borthalmue/rcm7-surgical-arm/images/card.jpg

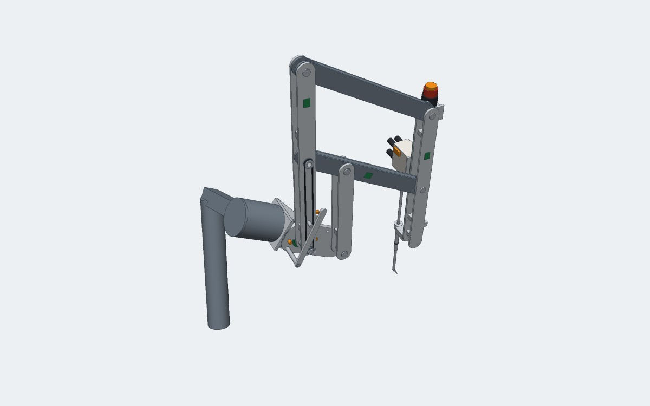
images/card.jpg
