borthalmue/rcm7-surgical-arm/images/insertion-stage.png

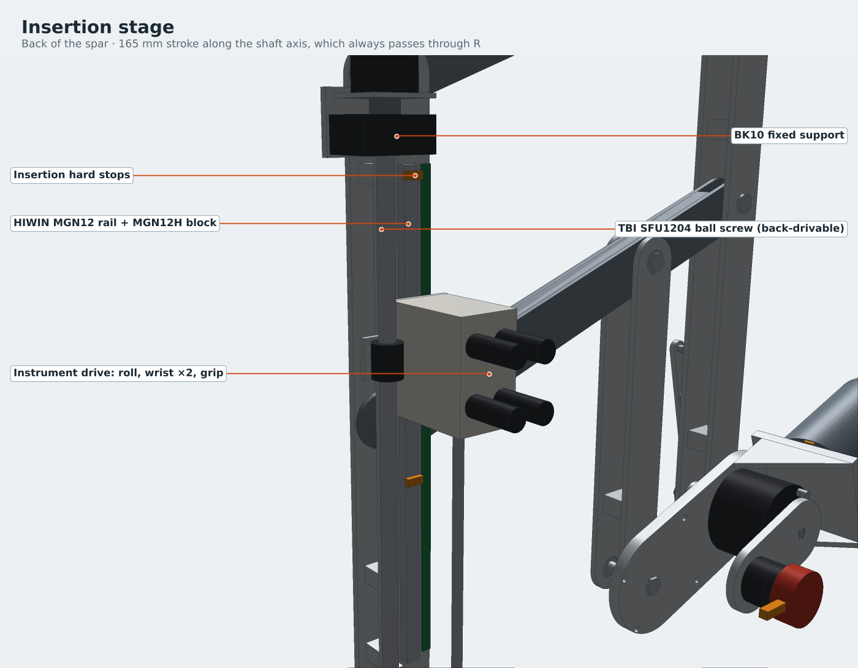
images/insertion-stage.png
