borthalmue/rcm7-surgical-arm/images/pitch-joint.png

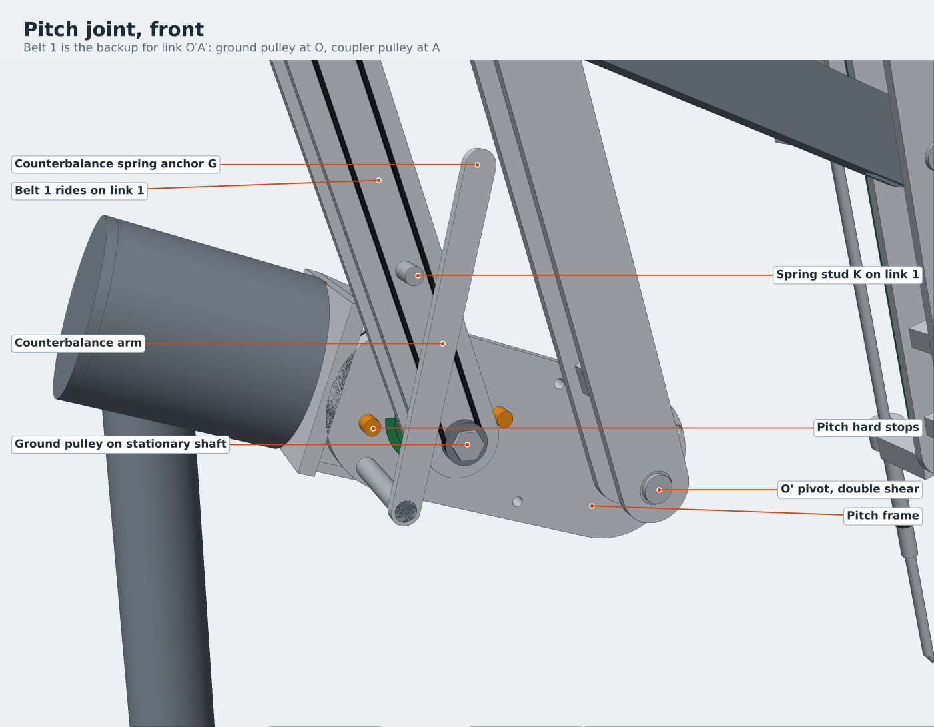
images/pitch-joint.png
