borthalmue/rcm7-surgical-arm/images/rcm-check.png

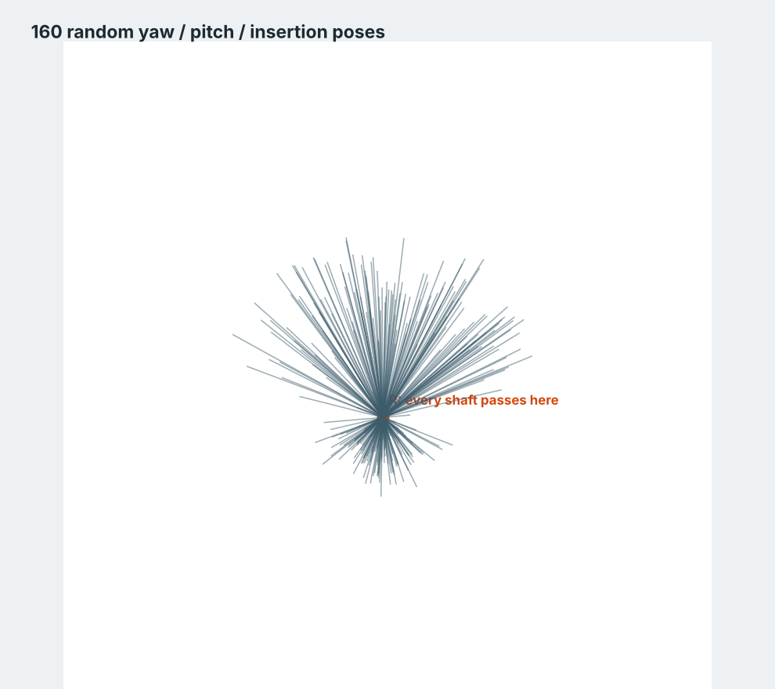
images/rcm-check.png
