borthalmue/rcm7-surgical-arm/cad/RCM7_assembly.stl

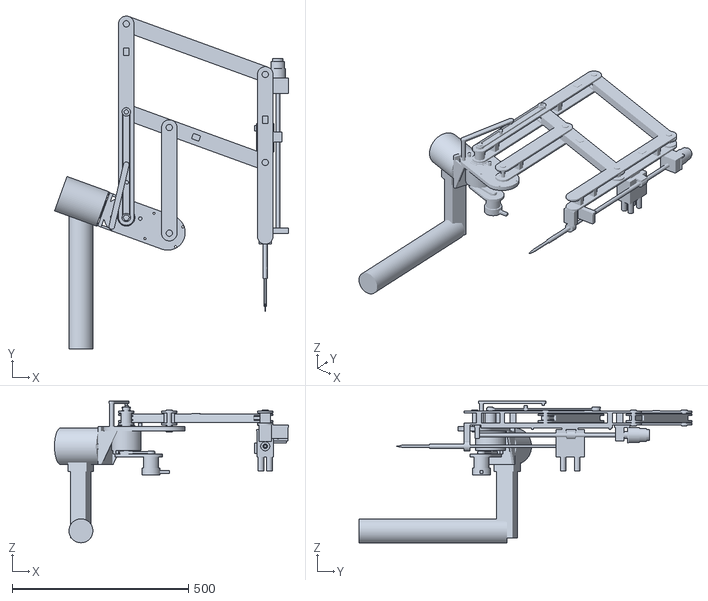
[picture p8: CAD file, 2026-10-20]
cad/RCM7_assembly.stl
664.5 x 945.1 x 402.0
