borthalmue/rcm7-surgical-arm/cad/stl/jaw_1.stl

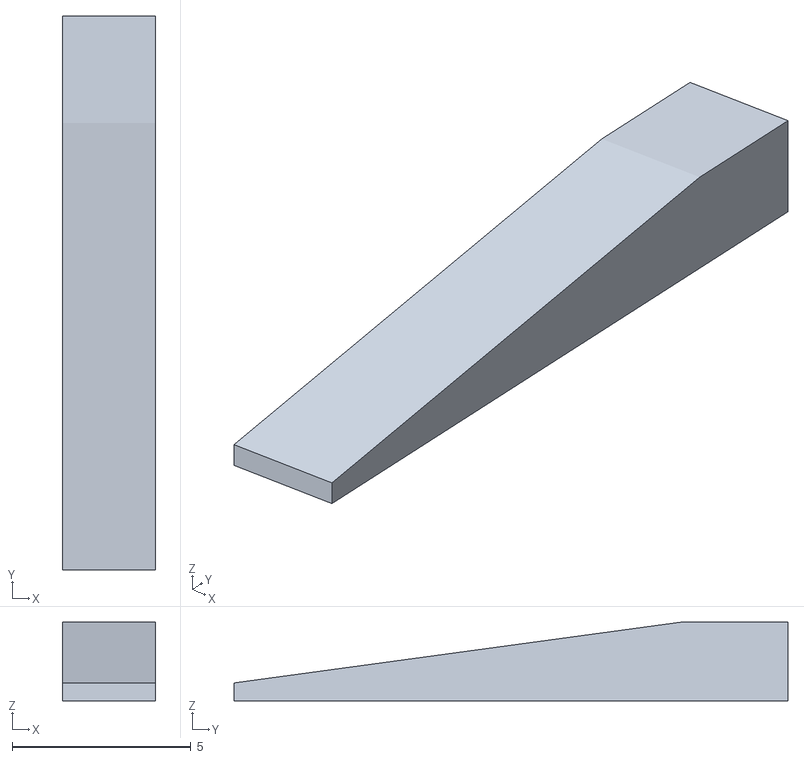
[picture p9: CAD file, 2026-10-20]
cad/stl/jaw_1.stl
2.60 x 15.5 x 2.20
