borthalmue/rcm7-surgical-arm/cad/stl/belt_1.stl

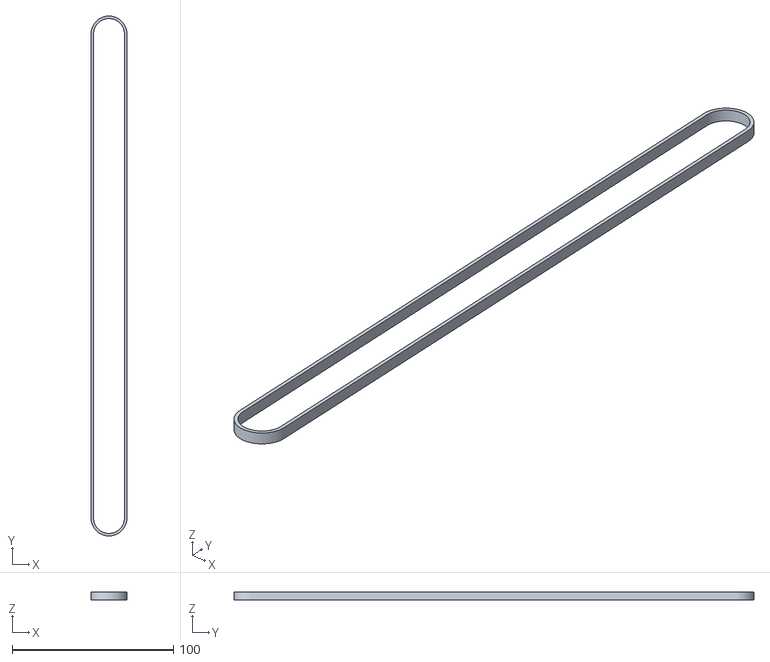
[picture p10: CAD file, 2026-10-20]
cad/stl/belt_1.stl
22.3 x 322.3 x 5.00
