borthalmue/rcm7-surgical-arm/cad/stl/brg_OpAp_front_0.stl

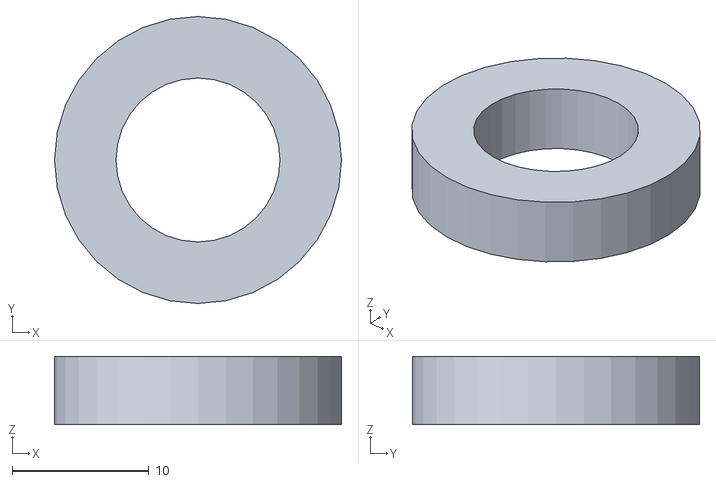
[picture p11: CAD file, 2026-10-20]
cad/stl/brg_OpAp_front_0.stl
21.0 x 21.0 x 5.00
