borthalmue/rcm7-surgical-arm/cad/stl/setup_beam.stl

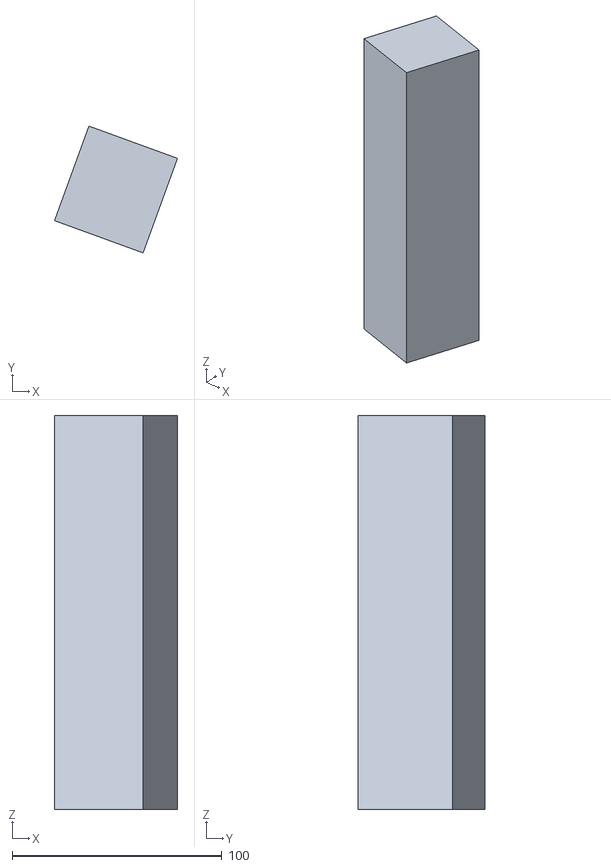
[picture p12: CAD file, 2026-10-20]
cad/stl/setup_beam.stl
58.7 x 60.5 x 188.0
