borthalmue/rcm7-surgical-arm/cad/stl/pitch_ground_shaft.stl

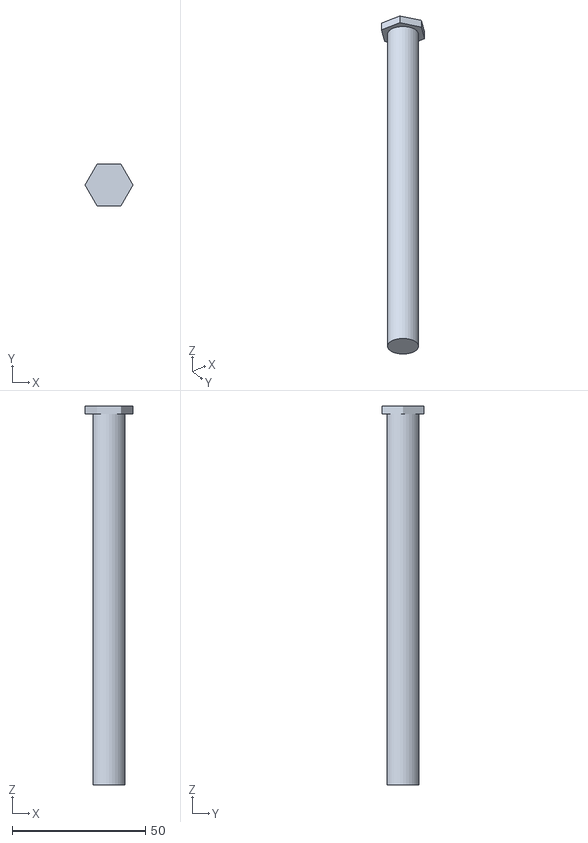
[picture p13: CAD file, 2026-10-20]
cad/stl/pitch_ground_shaft.stl
18.0 x 15.6 x 142.0
