borthalmue/rcm7-surgical-arm/cad/stl/insertion_motor.stl

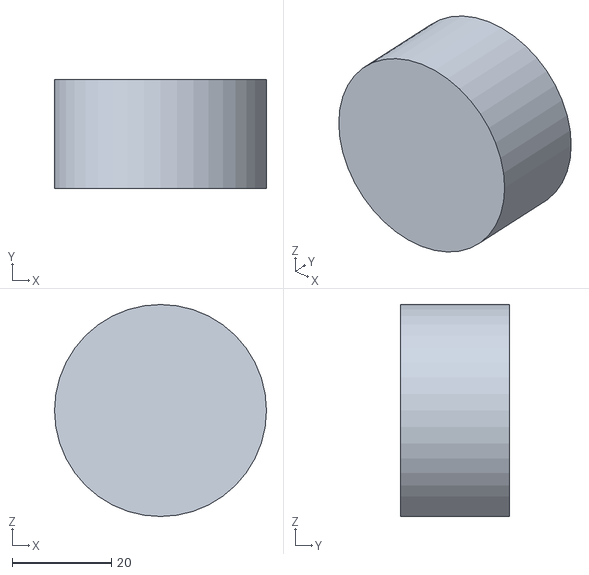
[picture p14: CAD file, 2026-10-20]
cad/stl/insertion_motor.stl
42.8 x 22.0 x 42.8
