borthalmue/rcm7-surgical-arm/cad/stl/coupler2_rail_R.stl

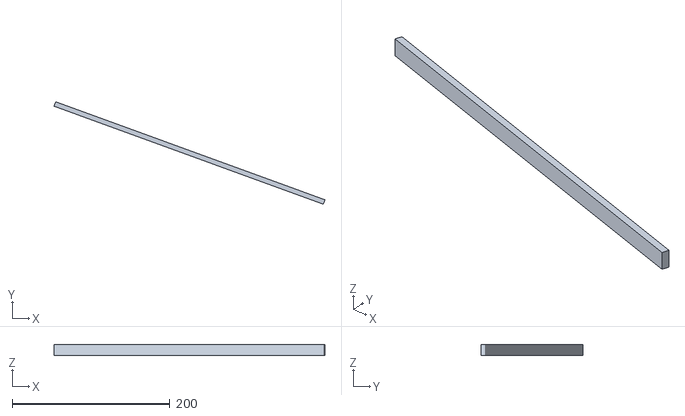
[picture p15: CAD file, 2026-10-20]
cad/stl/coupler2_rail_R.stl
344.1 x 130.1 x 14.0
