borthalmue/rcm7-surgical-arm/cad/stl/spring_post.stl

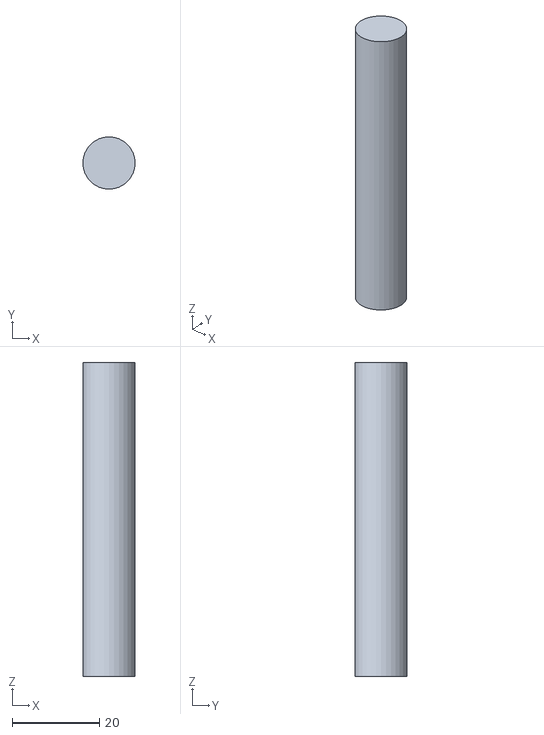
[picture p16: CAD file, 2026-10-20]
cad/stl/spring_post.stl
12.0 x 12.0 x 72.0
