borthalmue/rcm7-surgical-arm/cad/stl/setup_column.stl

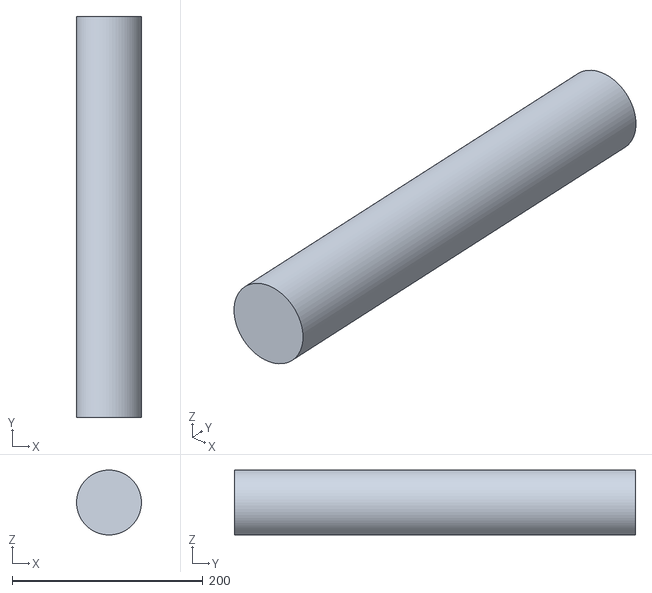
[picture p17: CAD file, 2026-10-20]
cad/stl/setup_column.stl
68.0 x 420.0 x 68.0
