borthalmue/rcm7-surgical-arm/cad/stl/link1_hub.stl

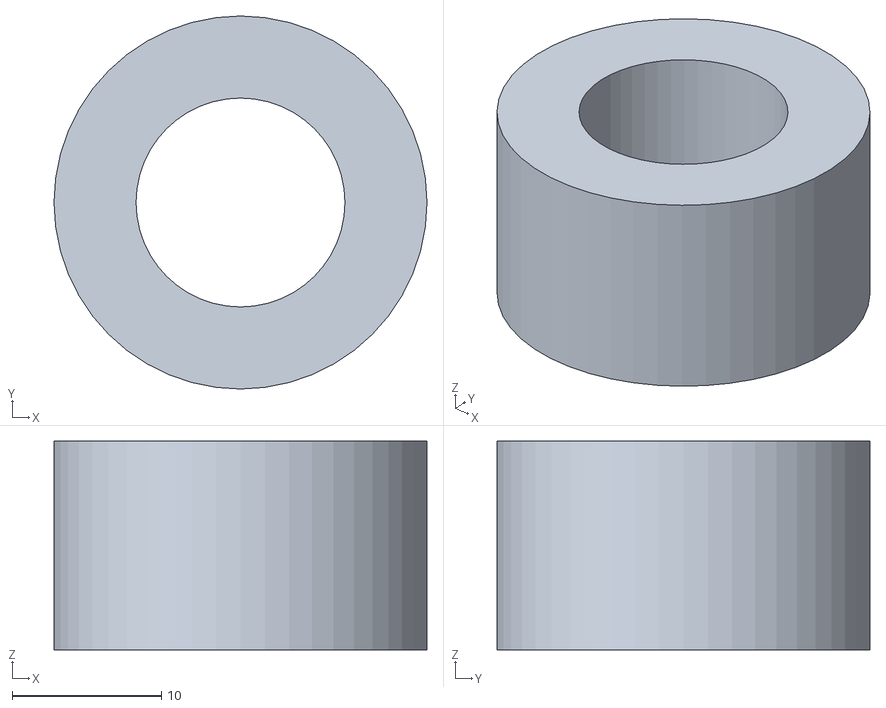
[picture p18: CAD file, 2026-10-20]
cad/stl/link1_hub.stl
25.0 x 25.0 x 14.0
