borthalmue/rcm7-surgical-arm/cad/stl/isa_motor_2.stl

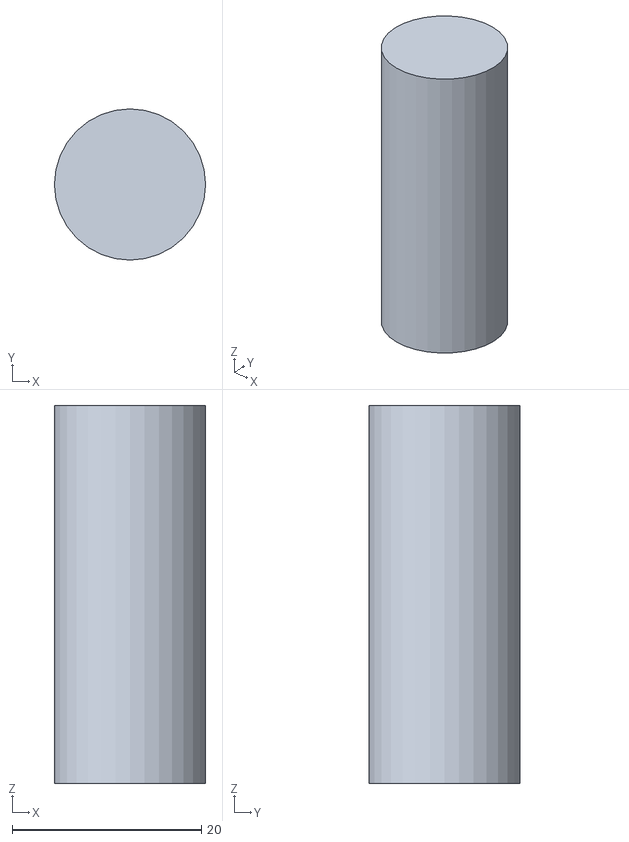
[picture p19: CAD file, 2026-10-20]
cad/stl/isa_motor_2.stl
16.0 x 16.0 x 40.0
