borthalmue/rcm7-surgical-arm/cad/stl/pin_Op.stl

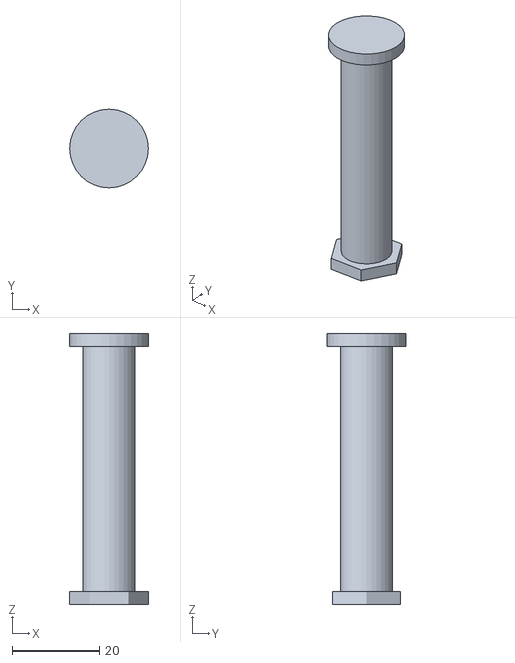
[picture p20: CAD file, 2026-10-20]
cad/stl/pin_Op.stl
18.0 x 18.0 x 62.0
