borthalmue/rcm7-surgical-arm/cad/stl/yaw_motor.stl

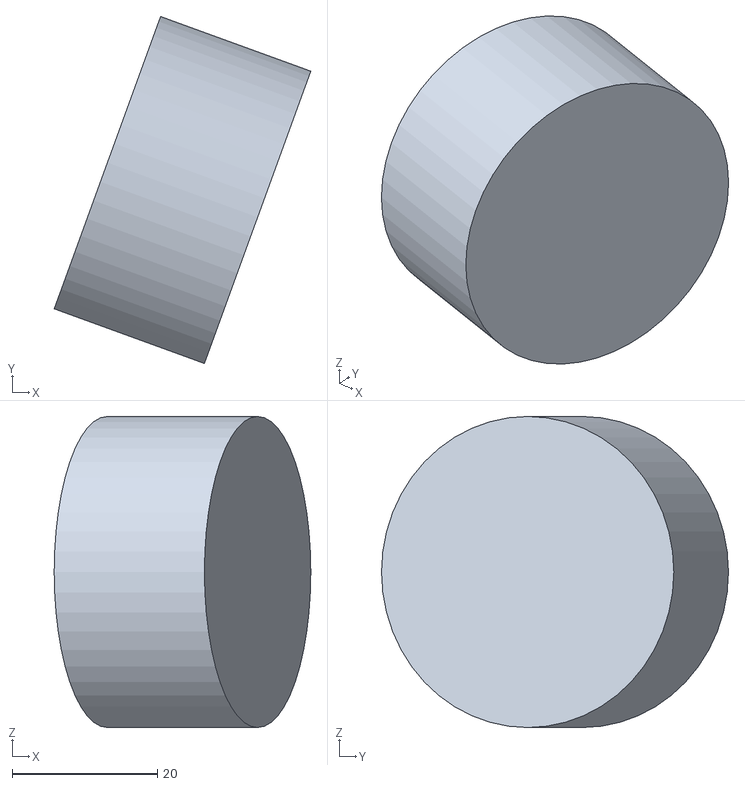
[picture p21: CAD file, 2026-10-20]
cad/stl/yaw_motor.stl
35.3 x 47.7 x 42.8
