borthalmue/rcm7-surgical-arm/cad/stl/link1_spacer_55.stl

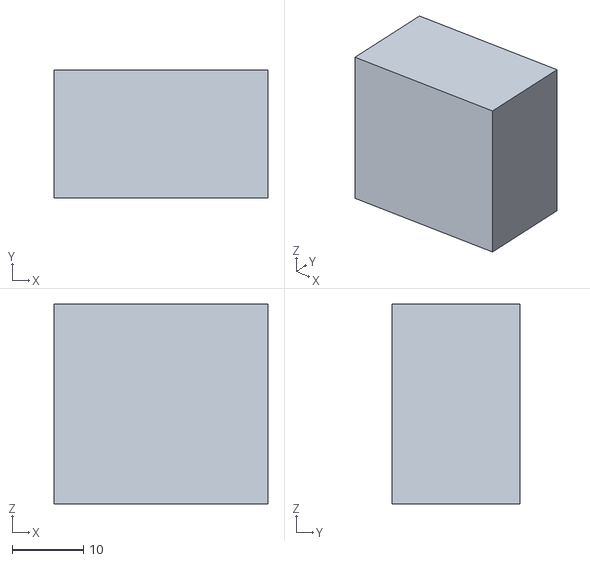
[picture p22: CAD file, 2026-10-20]
cad/stl/link1_spacer_55.stl
30.0 x 18.0 x 28.0
