borthalmue/rcm7-surgical-arm/cad/stl/yaw_motor_enc.stl

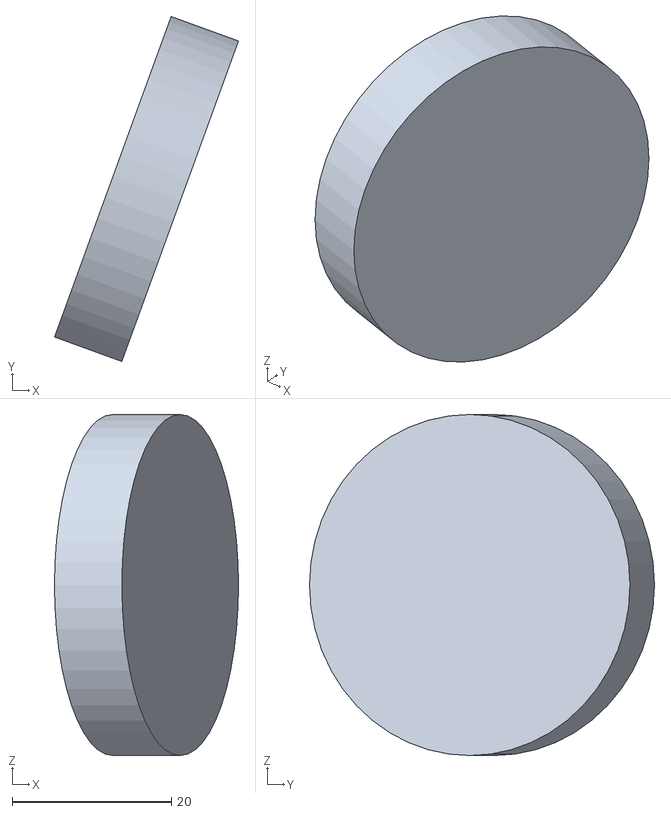
[picture p23: CAD file, 2026-10-20]
cad/stl/yaw_motor_enc.stl
23.1 x 43.3 x 42.8
