borthalmue/rcm7-surgical-arm/cad/stl/coupler2_wall_back.stl

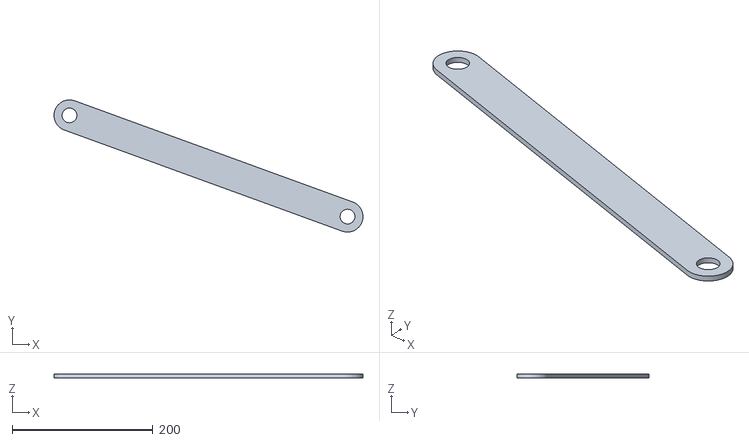
[picture p24: CAD file, 2026-10-20]
cad/stl/coupler2_wall_back.stl
438.6 x 187.6 x 5.00
