borthalmue/rcm7-surgical-arm/cad/stl/imu_link1.stl

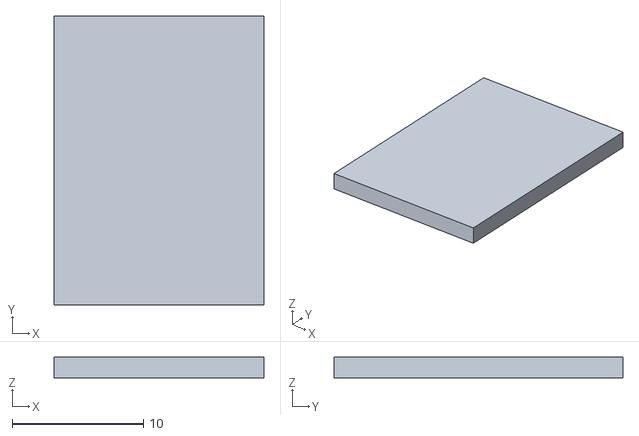
[picture p25: CAD file, 2026-10-20]
cad/stl/imu_link1.stl
16.0 x 22.0 x 1.60
