borthalmue/rcm7-surgical-arm/cad/stl/pitch_input_belt.stl

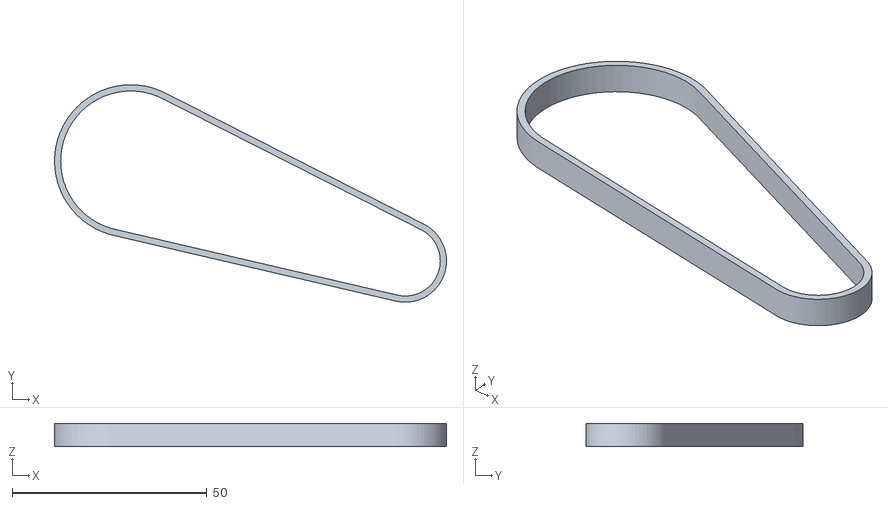
[picture p26: CAD file, 2026-10-20]
cad/stl/pitch_input_belt.stl
100.7 x 55.9 x 6.00
