borthalmue/rcm7-surgical-arm/cad/stl/pitch_hardstop_2.stl

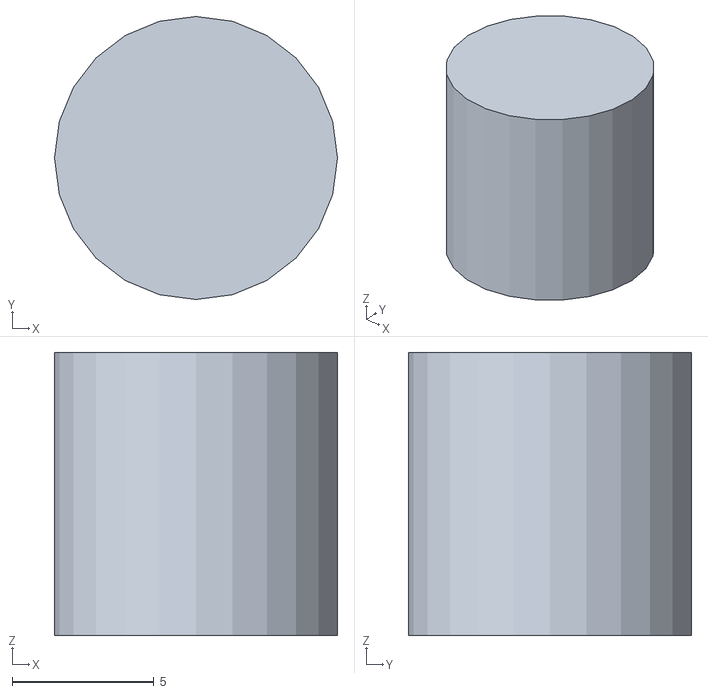
[picture p27: CAD file, 2026-10-20]
cad/stl/pitch_hardstop_2.stl
10.0 x 10.0 x 10.0
