borthalmue/rcm7-surgical-arm/cad/stl/spring_stud_K.stl

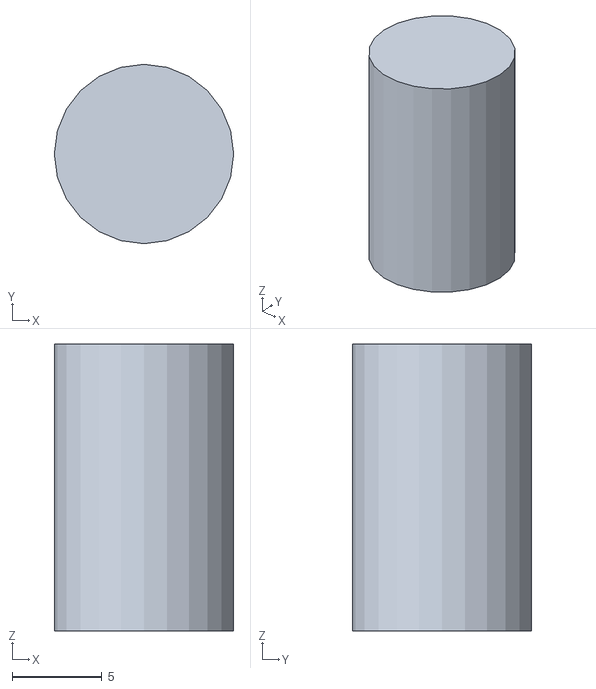
[picture p28: CAD file, 2026-10-20]
cad/stl/spring_stud_K.stl
10.0 x 10.0 x 16.0
