borthalmue/rcm7-surgical-arm/cad/stl/link1_plate_front.stl

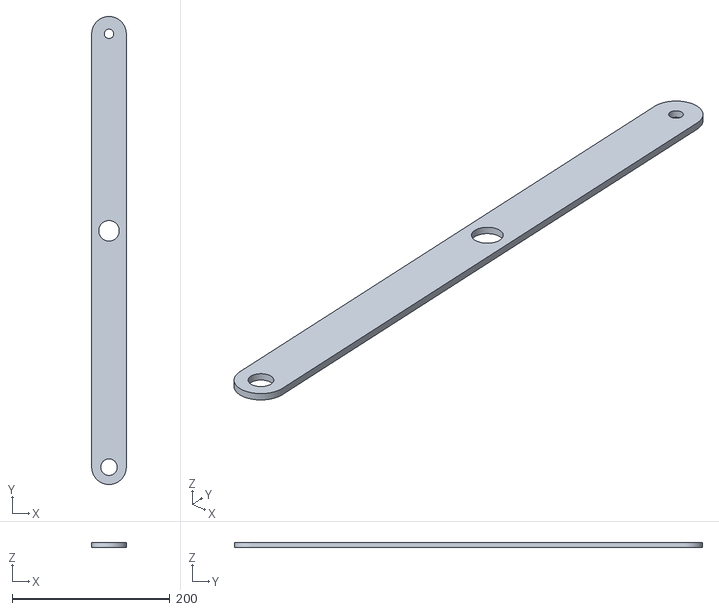
[picture p29: CAD file, 2026-10-20]
cad/stl/link1_plate_front.stl
44.0 x 594.0 x 6.00
