borthalmue/rcm7-surgical-arm/cad/stl/carriage_plate.stl

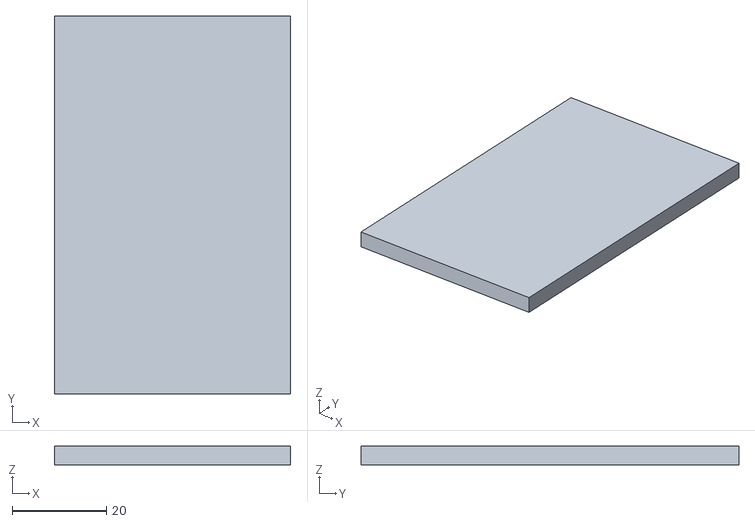
[picture p30: CAD file, 2026-10-20]
cad/stl/carriage_plate.stl
50.0 x 80.0 x 4.00
