borthalmue/rcm7-surgical-arm/cad/stl/yaw_hardstop_2.stl

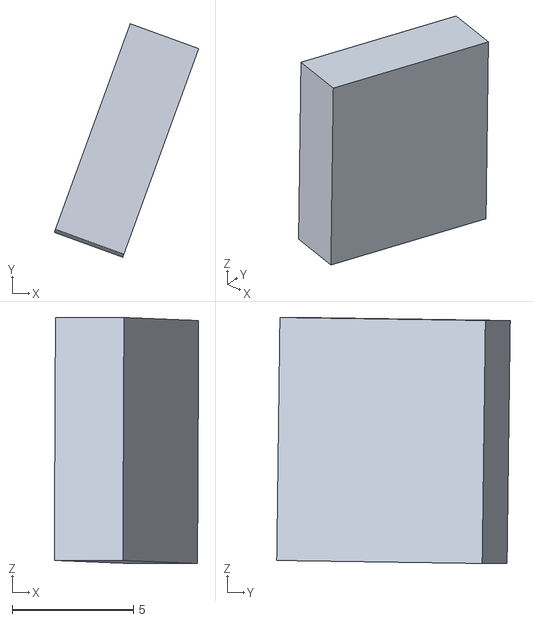
[picture p31: CAD file, 2026-10-20]
cad/stl/yaw_hardstop_2.stl
5.94 x 9.61 x 10.1
