borthalmue/rcm7-surgical-arm/cad/stl/insertion_stop_180.stl

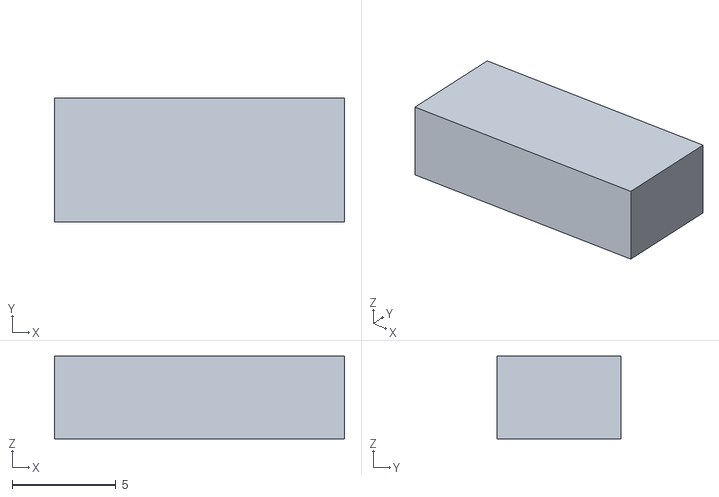
[picture p32: CAD file, 2026-10-20]
cad/stl/insertion_stop_180.stl
14.0 x 6.00 x 4.00
