borthalmue/rcm7-surgical-arm/cad/stl/insertion_scale.stl

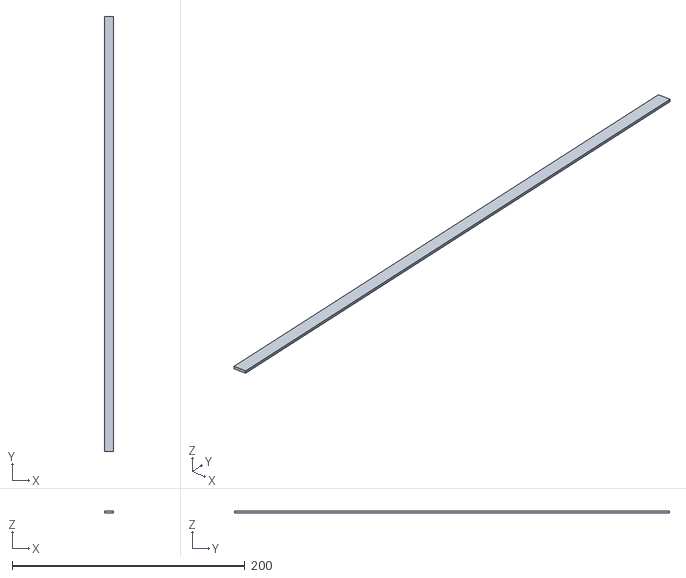
[picture p33: CAD file, 2026-10-20]
cad/stl/insertion_scale.stl
8.00 x 374.0 x 1.50
