borthalmue/rcm7-surgical-arm/cad/stl/pitch_brake_release.stl

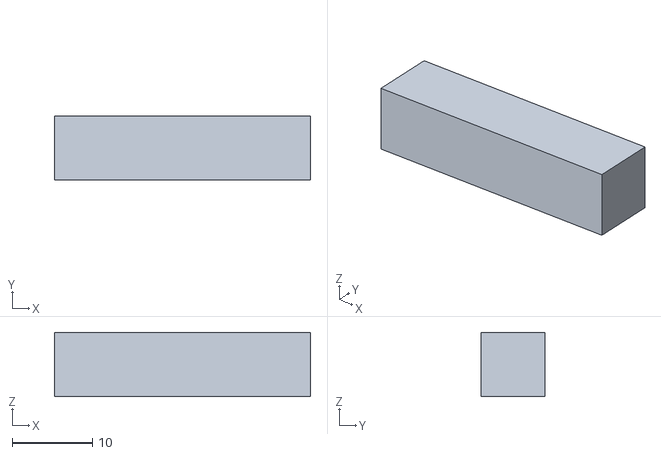
[picture p34: CAD file, 2026-10-20]
cad/stl/pitch_brake_release.stl
32.0 x 8.00 x 8.00
