borthalmue/rcm7-surgical-arm/cad/stl/pitch_rear_bracket.stl

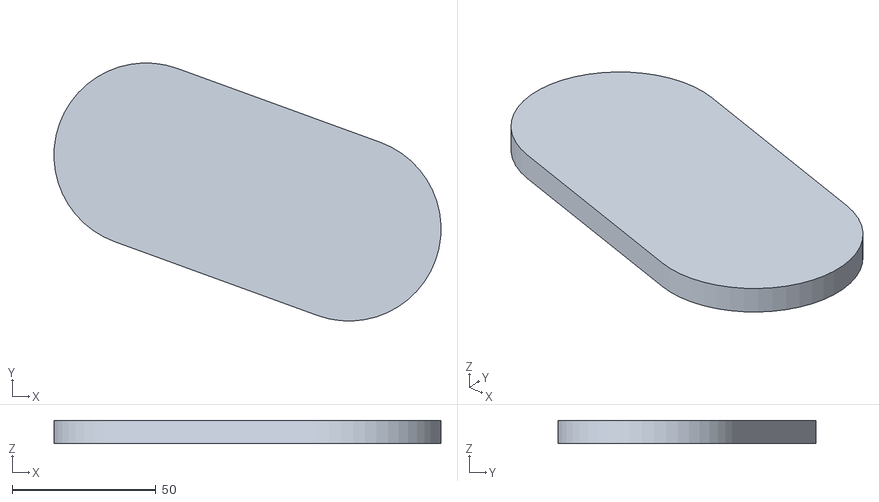
[picture p35: CAD file, 2026-10-20]
cad/stl/pitch_rear_bracket.stl
134.4 x 89.6 x 8.00
