borthalmue/rcm7-surgical-arm/cad/stl/yaw_housing.stl

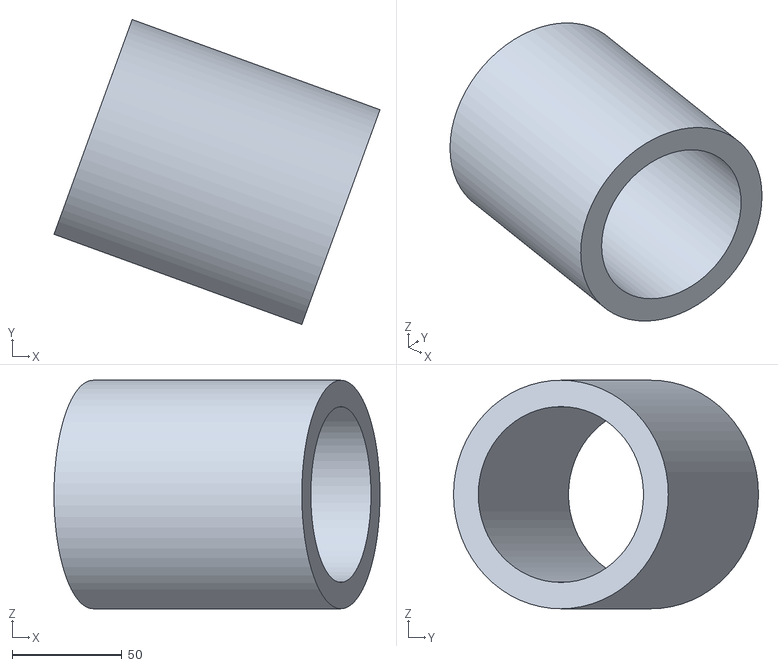
[picture p36: CAD file, 2026-10-20]
cad/stl/yaw_housing.stl
148.3 x 138.8 x 104.0
