borthalmue/rcm7-surgical-arm/cad/stl/insertion_brake.stl

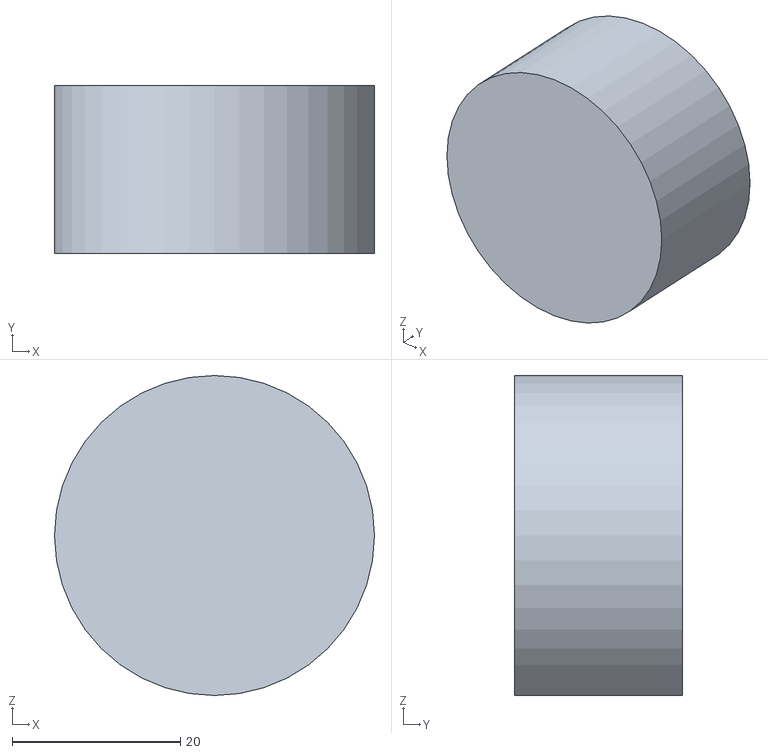
[picture p37: CAD file, 2026-10-20]
cad/stl/insertion_brake.stl
38.0 x 20.0 x 38.0
