borthalmue/rcm7-surgical-arm/cad/stl/yaw_hd_output.stl

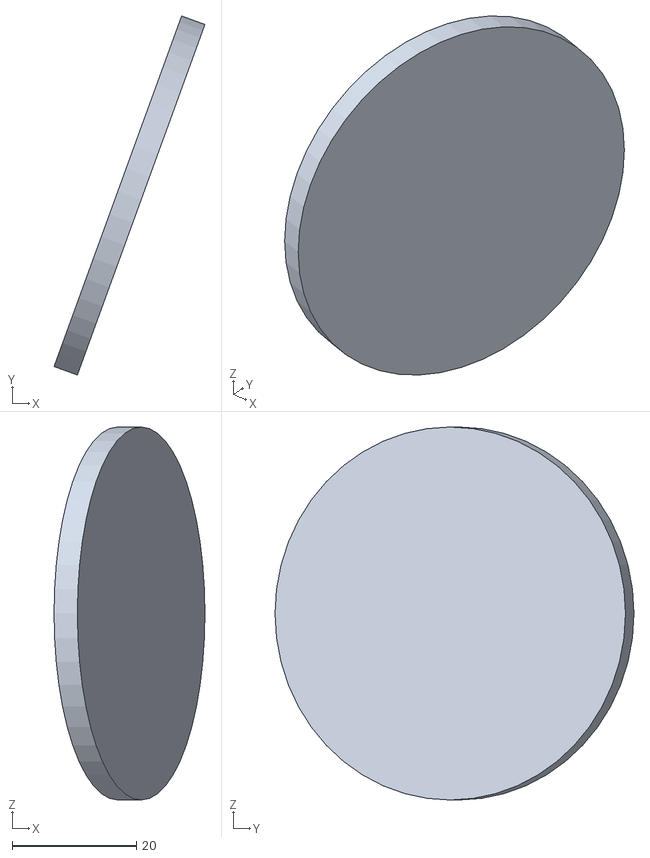
[picture p38: CAD file, 2026-10-20]
cad/stl/yaw_hd_output.stl
24.3 x 57.7 x 60.0
