borthalmue/rcm7-surgical-arm/cad/stl/pin_C.stl

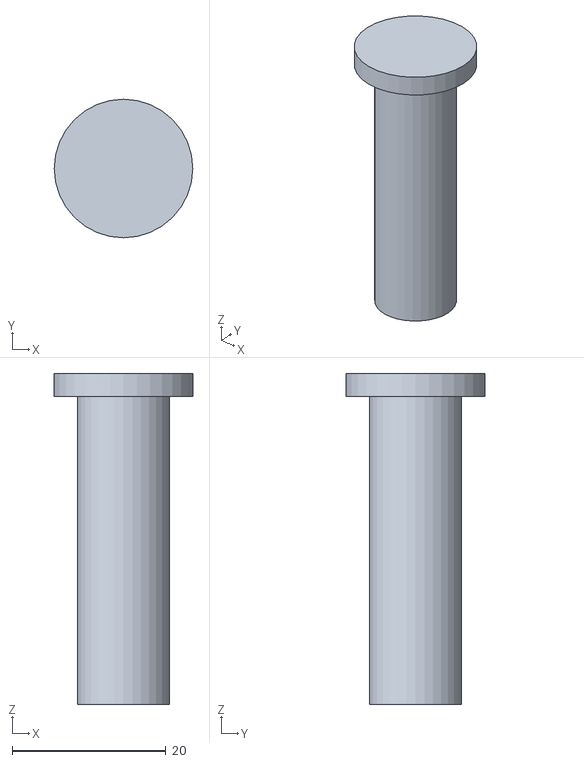
[picture p39: CAD file, 2026-10-20]
cad/stl/pin_C.stl
18.0 x 18.0 x 43.0
