borthalmue/rcm7-surgical-arm/cad/stl/yoke_gusset_R.stl

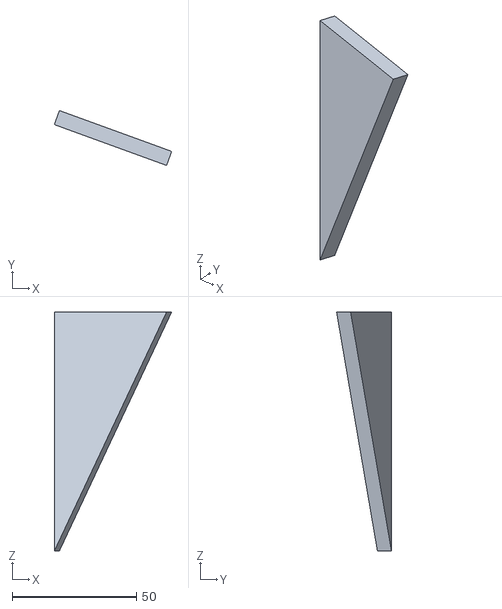
[picture p40: CAD file, 2026-10-20]
cad/stl/yoke_gusset_R.stl
47.2 x 22.1 x 96.0
