borthalmue/rcm7-surgical-arm/cad/stl/pulley_1b_A.stl

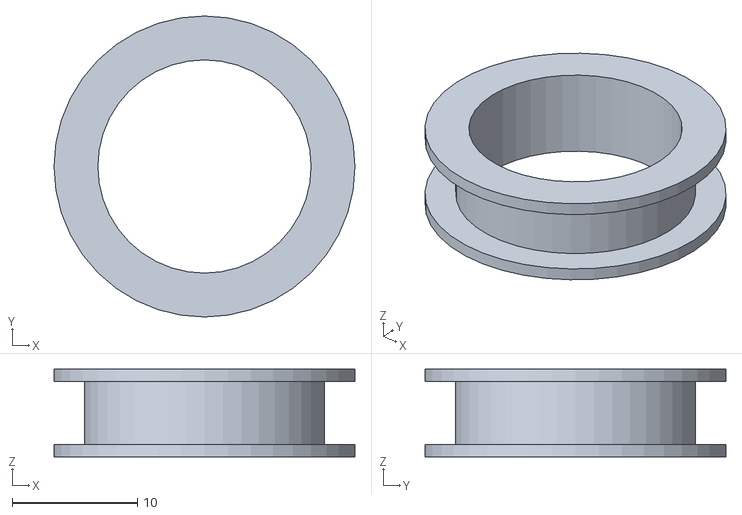
[picture p41: CAD file, 2026-10-20]
cad/stl/pulley_1b_A.stl
24.0 x 24.0 x 7.00
