borthalmue/rcm7-surgical-arm/cad/stl/instrument_shaft.stl

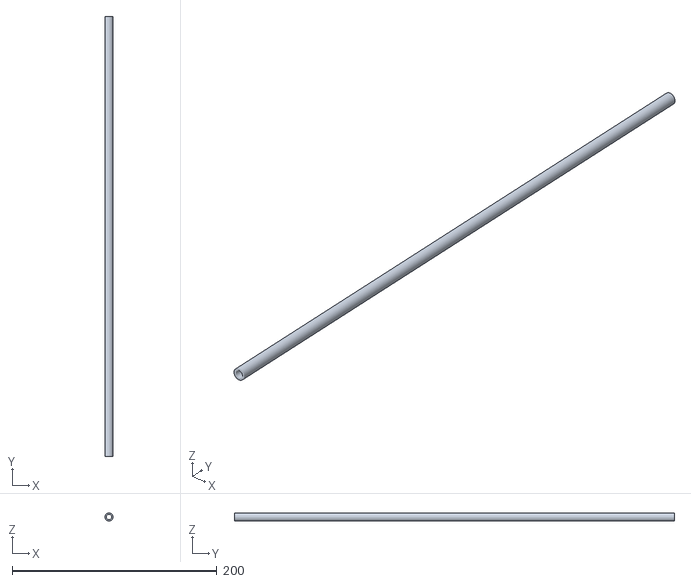
[picture p42: CAD file, 2026-10-20]
cad/stl/instrument_shaft.stl
8.00 x 430.0 x 8.00
