borthalmue/rcm7-surgical-arm/cad/stl/pitch_input_pulley.stl

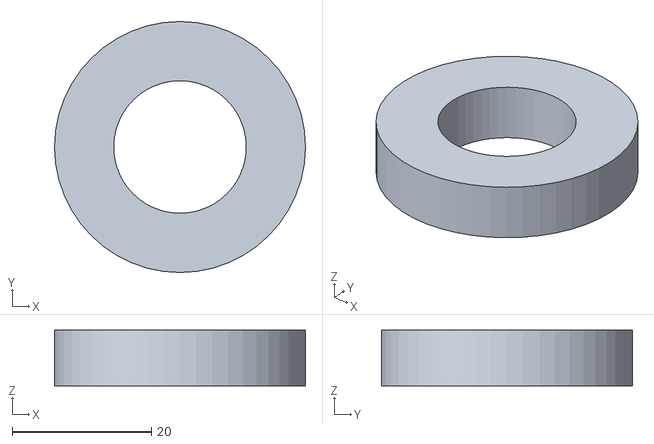
[picture p43: CAD file, 2026-10-20]
cad/stl/pitch_input_pulley.stl
36.0 x 36.0 x 8.00
