borthalmue/rcm7-surgical-arm/cad/stl/setup_saddle.stl

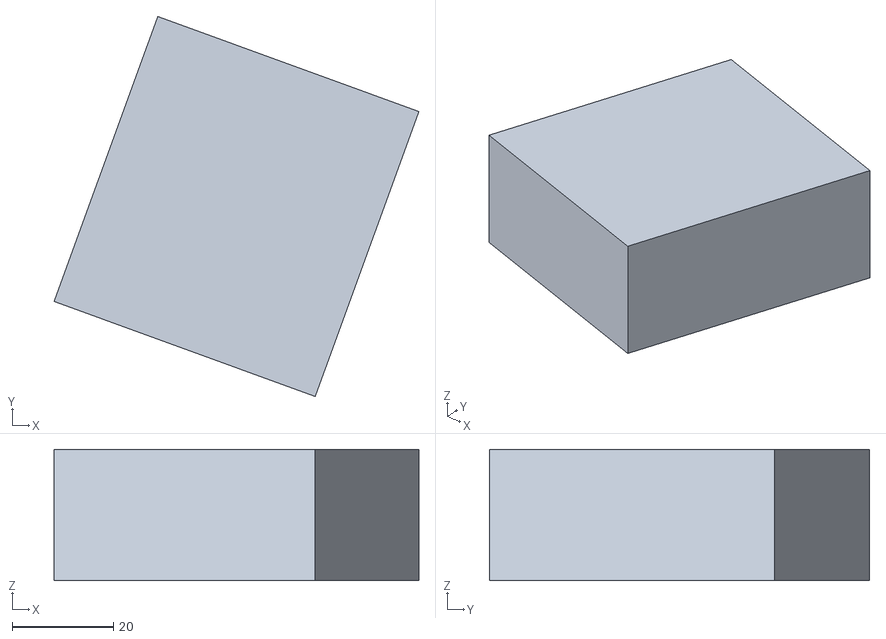
[picture p44: CAD file, 2026-10-20]
cad/stl/setup_saddle.stl
72.2 x 75.2 x 26.0
