borthalmue/rcm7-surgical-arm/cad/stl/imu_coupler1.stl

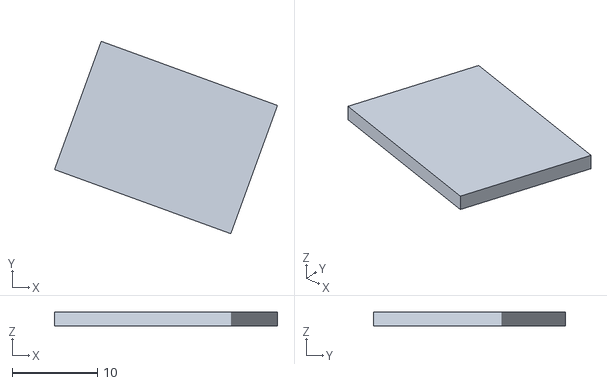
[picture p45: CAD file, 2026-10-20]
cad/stl/imu_coupler1.stl
26.1 x 22.6 x 1.60
