borthalmue/rcm7-surgical-arm/cad/stl/insertion_motor_plate.stl

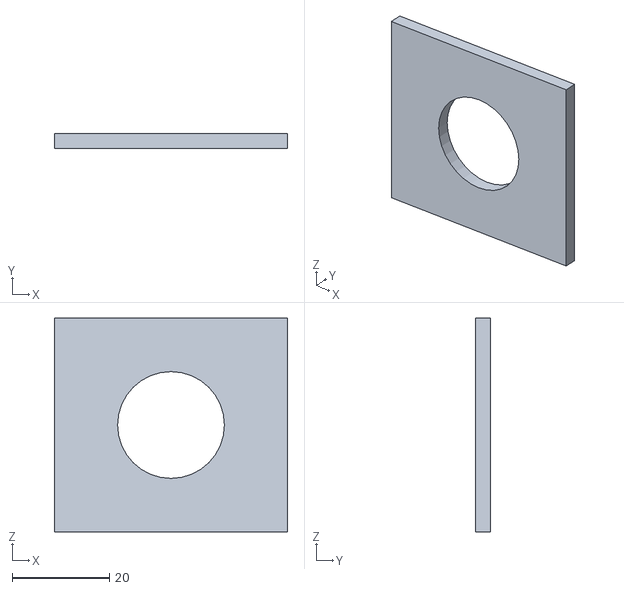
[picture p46: CAD file, 2026-10-20]
cad/stl/insertion_motor_plate.stl
48.0 x 3.00 x 44.0
