borthalmue/rcm7-surgical-arm/cad/stl/spar_spacer_-196.stl

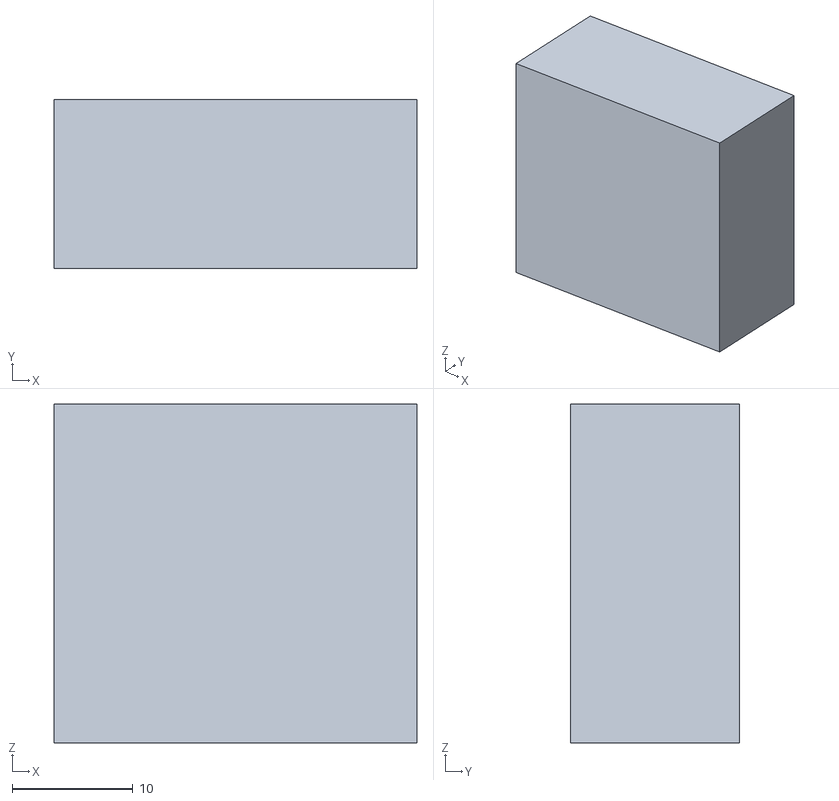
[picture p47: CAD file, 2026-10-20]
cad/stl/spar_spacer_-196.stl
30.0 x 14.0 x 28.0
