borthalmue/rcm7-surgical-arm/cad/stl/pulley_1a_O.stl

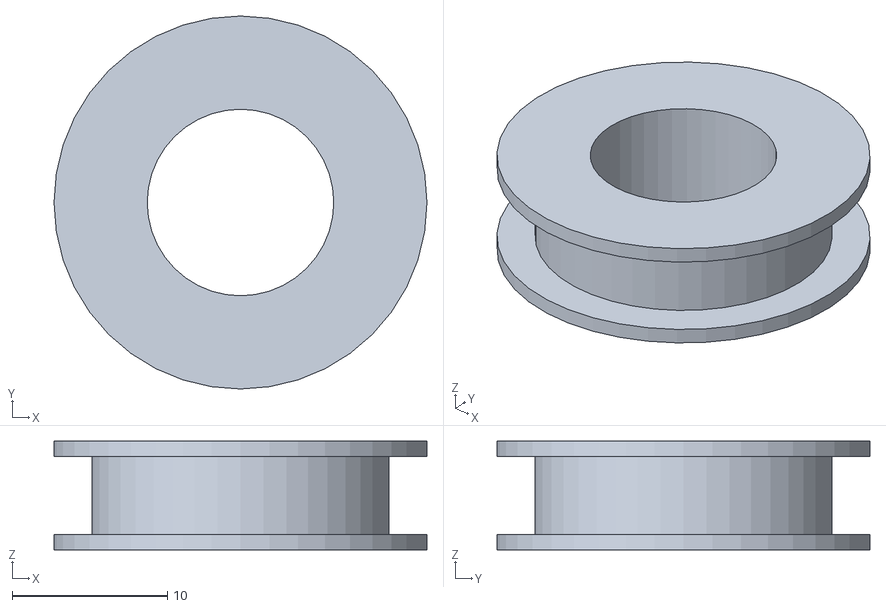
[picture p48: CAD file, 2026-10-20]
cad/stl/pulley_1a_O.stl
24.0 x 24.0 x 7.00
