borthalmue/rcm7-surgical-arm/cad/stl/yaw_harmonic.stl

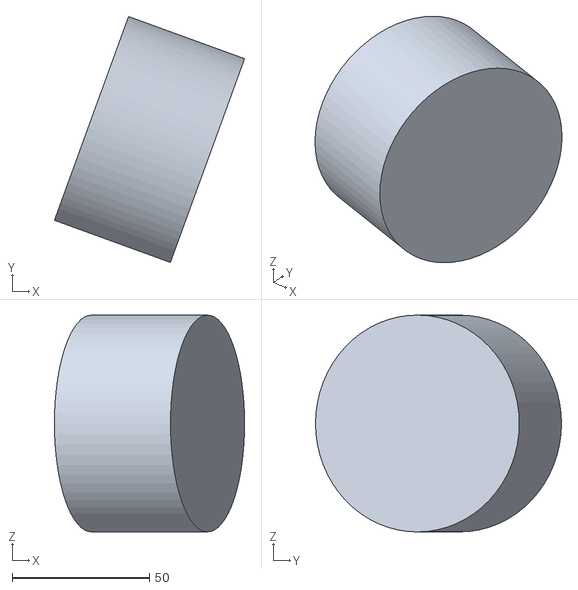
[picture p49: CAD file, 2026-10-20]
cad/stl/yaw_harmonic.stl
69.3 x 89.6 x 79.0
