borthalmue/rcm7-surgical-arm/cad/stl/pitch_motor_enc.stl

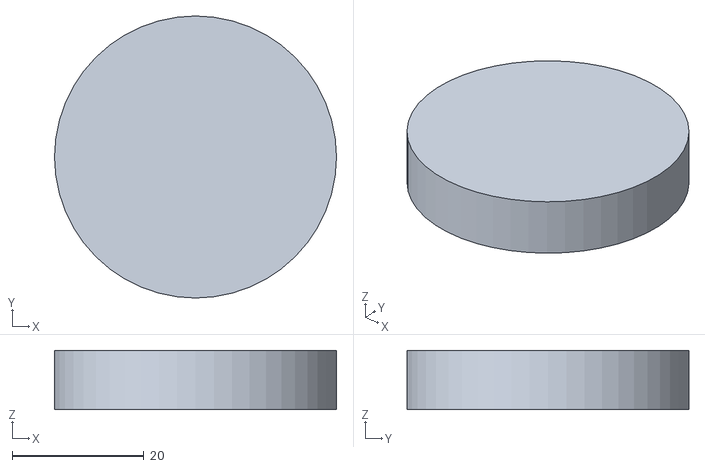
[picture p50: CAD file, 2026-10-20]
cad/stl/pitch_motor_enc.stl
42.8 x 42.8 x 9.00
