borthalmue/rcm7-surgical-arm/cad/stl/belt_2.stl

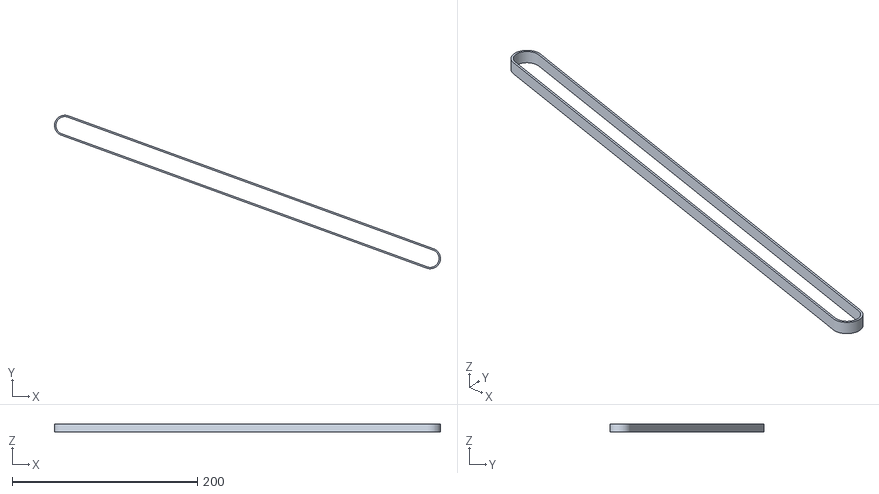
[picture p51: CAD file, 2026-10-20]
cad/stl/belt_2.stl
416.9 x 165.9 x 9.00
