borthalmue/rcm7-surgical-arm/cad/stl/yaw_end_cap.stl

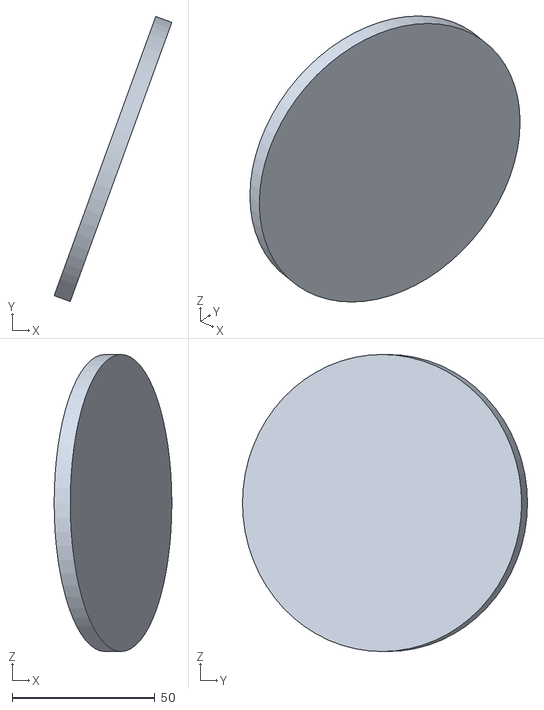
[picture p52: CAD file, 2026-10-20]
cad/stl/yaw_end_cap.stl
41.2 x 99.8 x 104.0
