borthalmue/rcm7-surgical-arm/cad/stl/isa_housing.stl

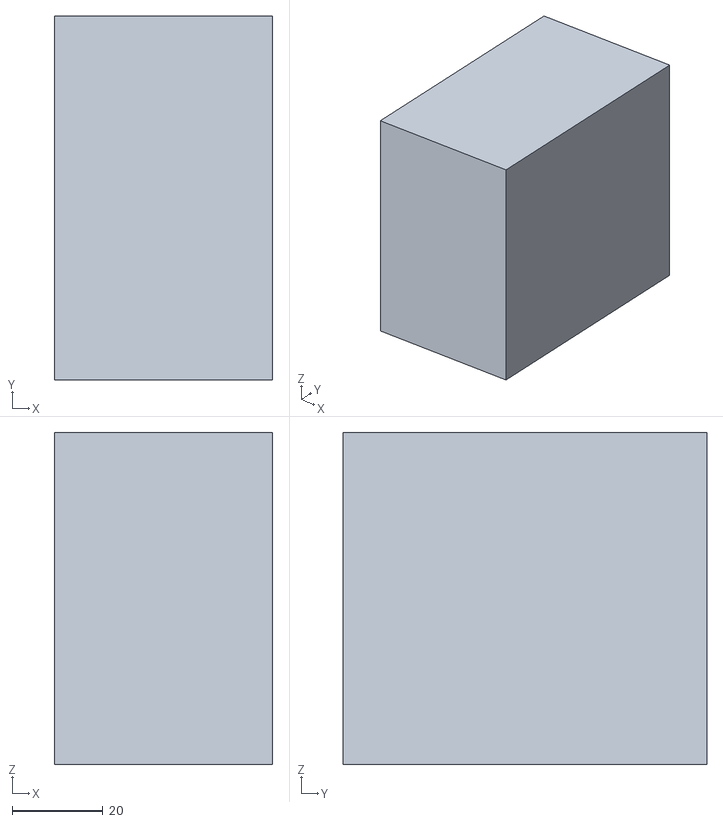
[picture p53: CAD file, 2026-10-20]
cad/stl/isa_housing.stl
48.0 x 80.0 x 73.0
