borthalmue/rcm7-surgical-arm/cad/stl/link1_enc_ring.stl

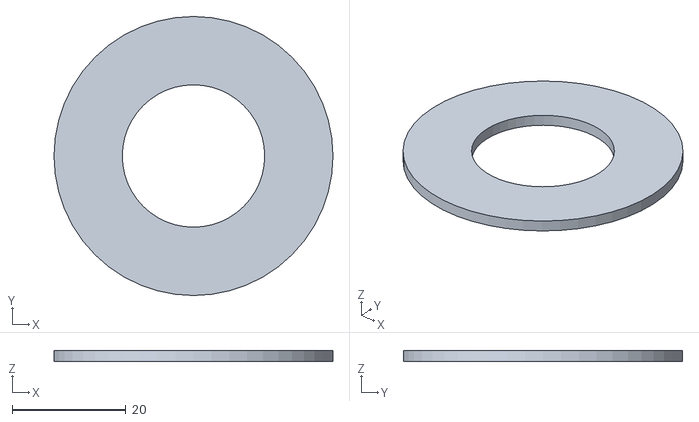
[picture p54: CAD file, 2026-10-20]
cad/stl/link1_enc_ring.stl
49.0 x 49.0 x 2.00
