borthalmue/rcm7-surgical-arm/cad/stl/spar_plate_front.stl

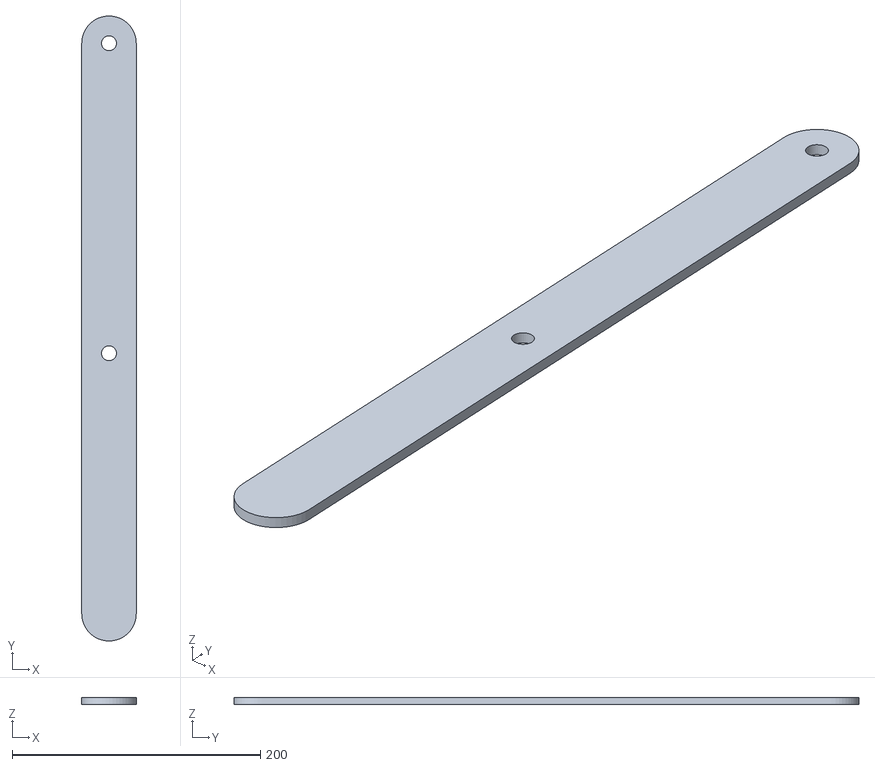
[picture p55: CAD file, 2026-10-20]
cad/stl/spar_plate_front.stl
44.0 x 504.0 x 6.00
