borthalmue/rcm7-surgical-arm/cad/stl/wrist_yaw_pin.stl

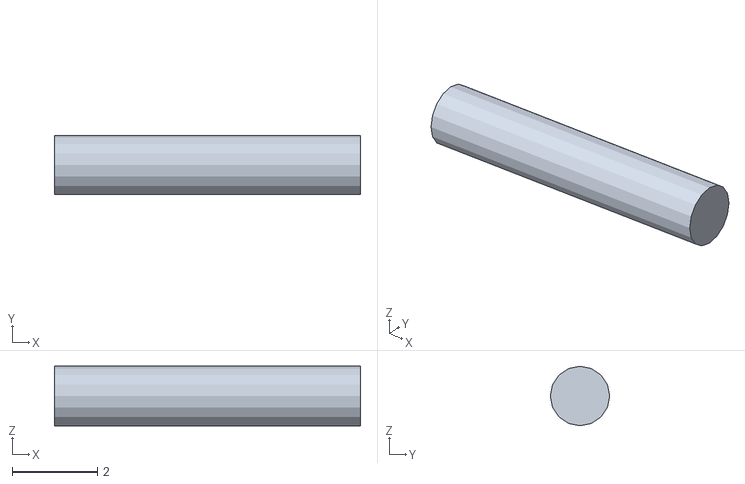
[picture p56: CAD file, 2026-10-20]
cad/stl/wrist_yaw_pin.stl
7.20 x 1.40 x 1.40
