borthalmue/rcm7-surgical-arm/cad/stl/pulley_2b_C.stl

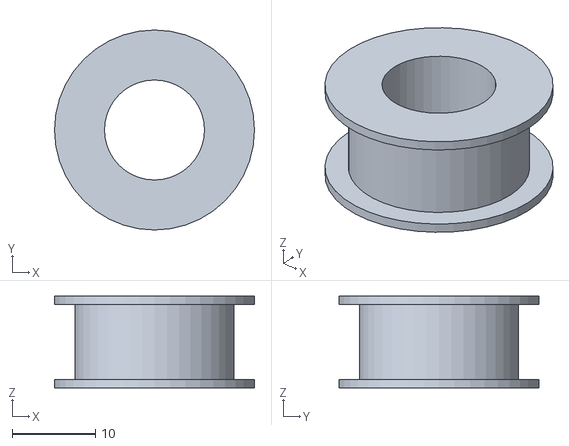
[picture p57: CAD file, 2026-10-20]
cad/stl/pulley_2b_C.stl
24.0 x 24.0 x 11.0
