borthalmue/rcm7-surgical-arm/cad/stl/sleeve_A.stl

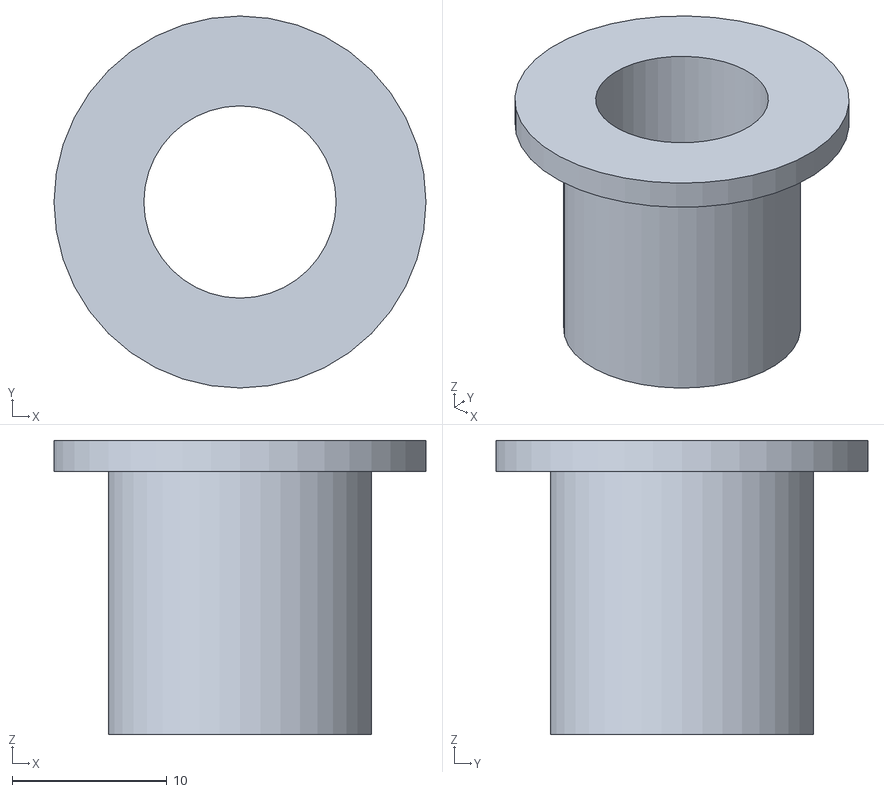
[picture p58: CAD file, 2026-10-20]
cad/stl/sleeve_A.stl
24.0 x 24.0 x 19.0
