borthalmue/rcm7-surgical-arm/cad/stl/yaw_stop_dog.stl

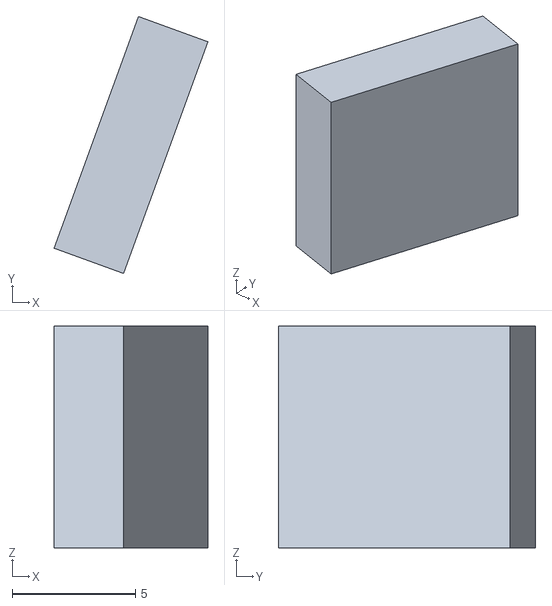
[picture p59: CAD file, 2026-10-20]
cad/stl/yaw_stop_dog.stl
6.24 x 10.4 x 9.00
