borthalmue/rcm7-surgical-arm/cad/stl/cannula_rcm_band.stl

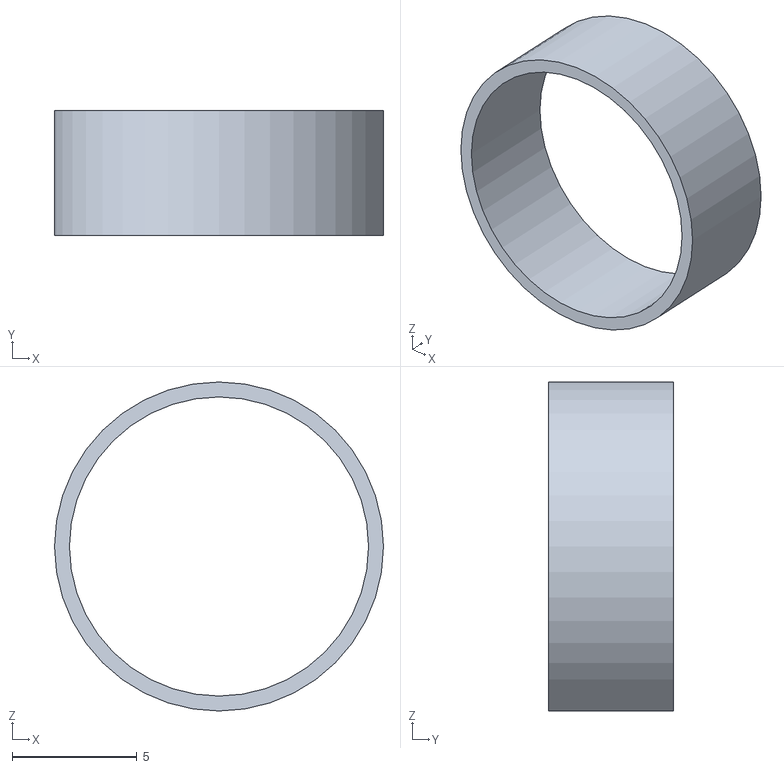
[picture p60: CAD file, 2026-10-20]
cad/stl/cannula_rcm_band.stl
13.2 x 5.00 x 13.2
