borthalmue/rcm7-surgical-arm/cad/stl/yaw_readhead.stl

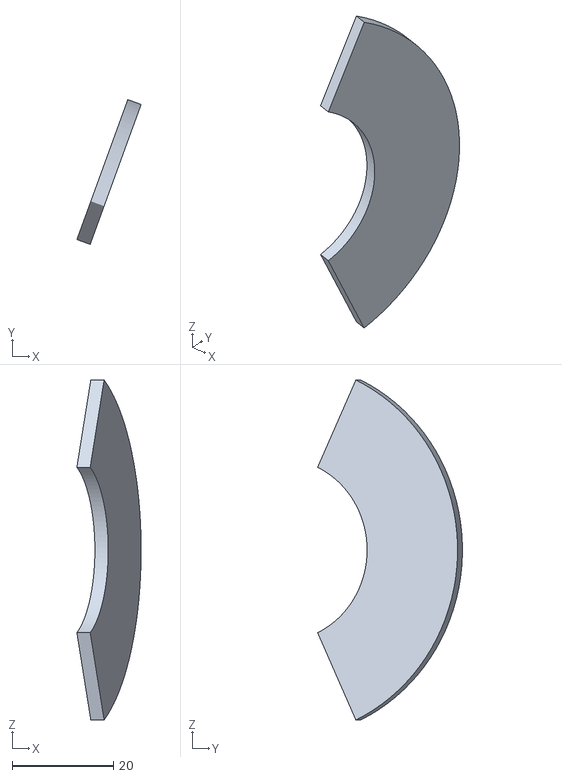
[picture p61: CAD file, 2026-10-20]
cad/stl/yaw_readhead.stl
12.7 x 28.6 x 67.1
