borthalmue/rcm7-surgical-arm/cad/stl/rail_MGN12.stl

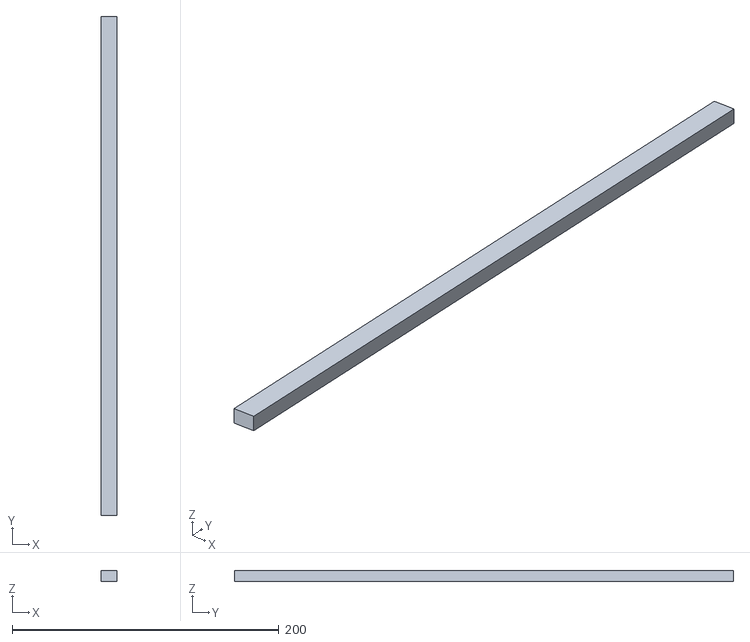
[picture p62: CAD file, 2026-10-20]
cad/stl/rail_MGN12.stl
12.0 x 374.0 x 8.00
