borthalmue/rcm7-surgical-arm/cad/stl/pitch_motor_pulley.stl

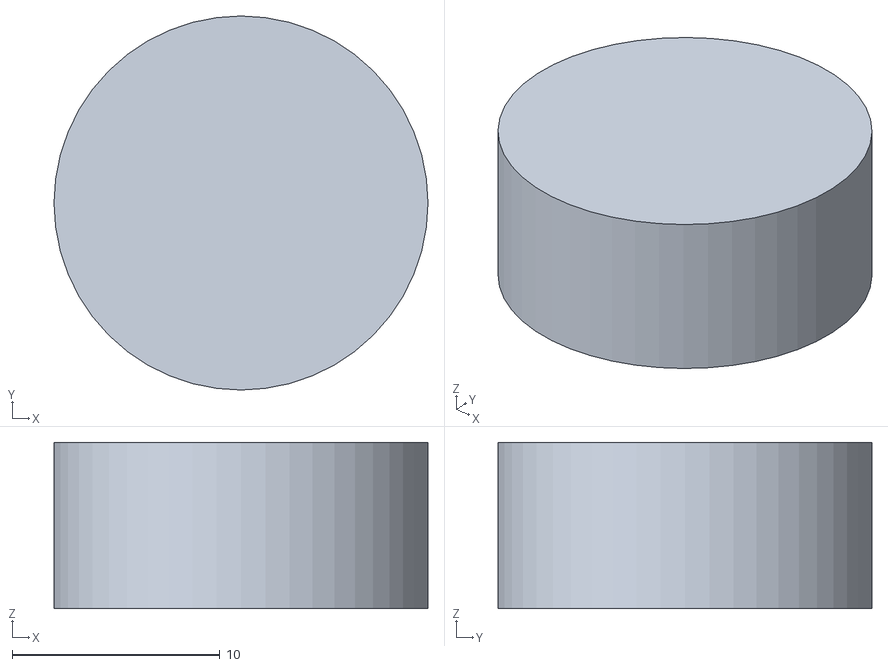
[picture p63: CAD file, 2026-10-20]
cad/stl/pitch_motor_pulley.stl
18.0 x 18.0 x 8.00
