borthalmue/rcm7-surgical-arm/cad/stl/brg_L1_A_front.stl

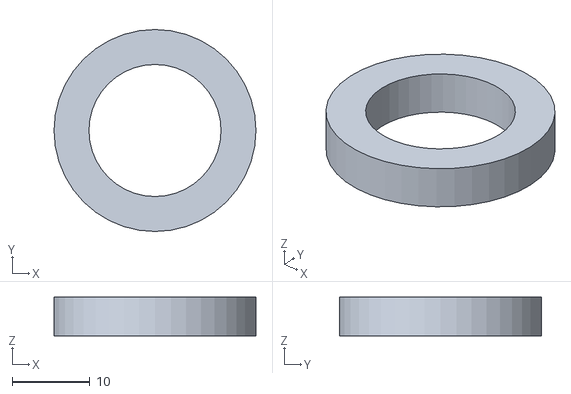
[picture p64: CAD file, 2026-10-20]
cad/stl/brg_L1_A_front.stl
26.0 x 26.0 x 5.00
