borthalmue/rcm7-surgical-arm/cad/stl/cannula_mount.stl

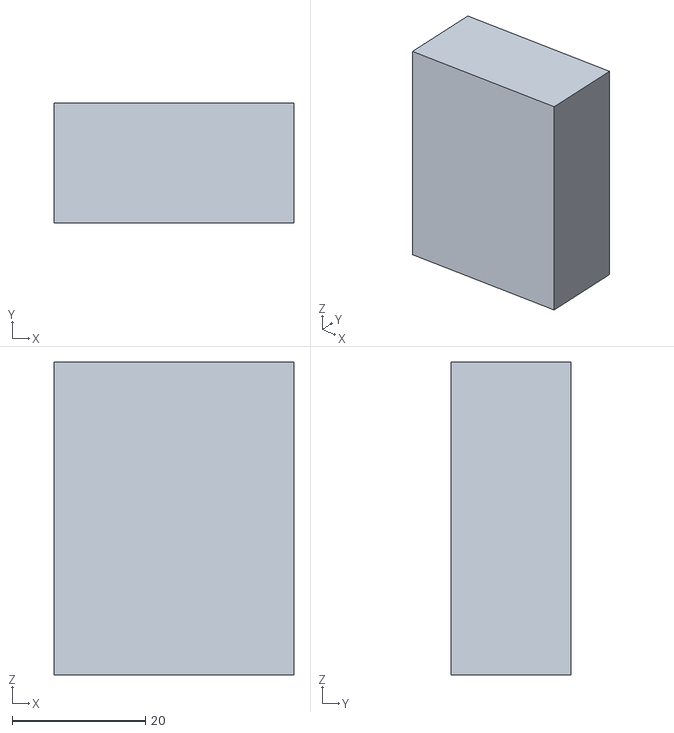
[picture p65: CAD file, 2026-10-20]
cad/stl/cannula_mount.stl
36.0 x 18.0 x 47.0
