borthalmue/rcm7-surgical-arm/cad/stl/yoke.stl

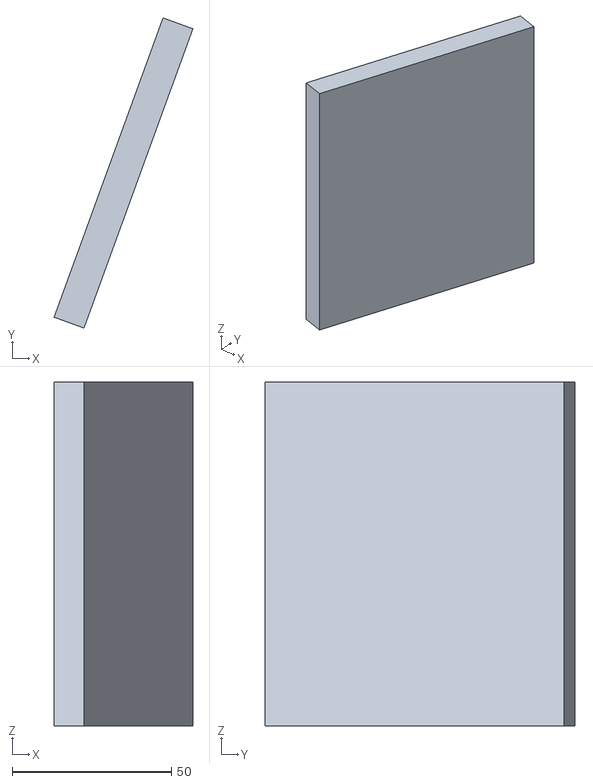
[picture p66: CAD file, 2026-10-20]
cad/stl/yoke.stl
43.6 x 97.4 x 108.0
