borthalmue/rcm7-surgical-arm/cad/stl/cannula_clamp.stl

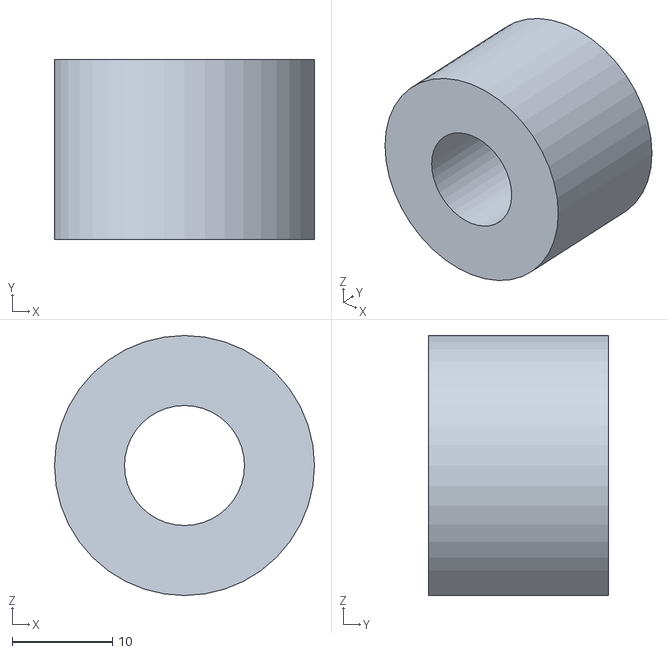
[picture p67: CAD file, 2026-10-20]
cad/stl/cannula_clamp.stl
26.0 x 18.0 x 26.0
