borthalmue/rcm7-surgical-arm/cad/stl/link1_plate_back.stl

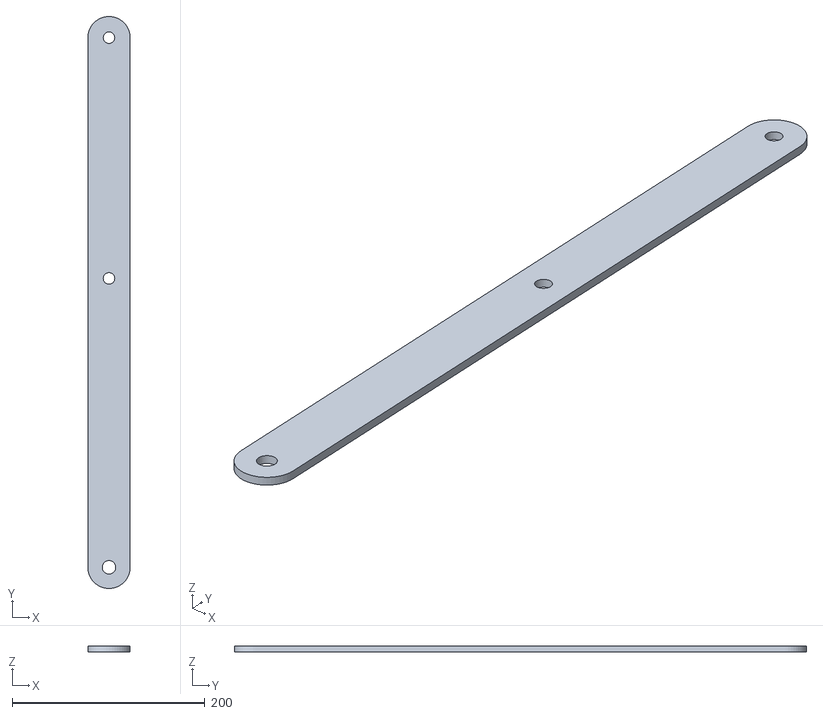
[picture p68: CAD file, 2026-10-20]
cad/stl/link1_plate_back.stl
44.0 x 594.0 x 6.00
