borthalmue/rcm7-surgical-arm/cad/stl/spring_arm.stl

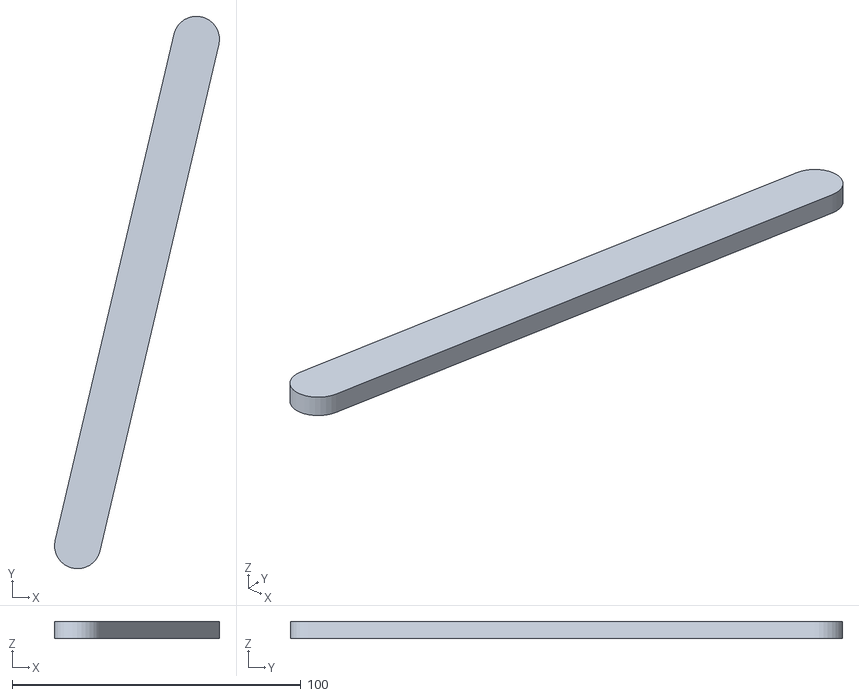
[picture p69: CAD file, 2026-10-20]
cad/stl/spring_arm.stl
57.2 x 191.4 x 6.00
