borthalmue/rcm7-surgical-arm/cad/stl/wrist_clevis.stl

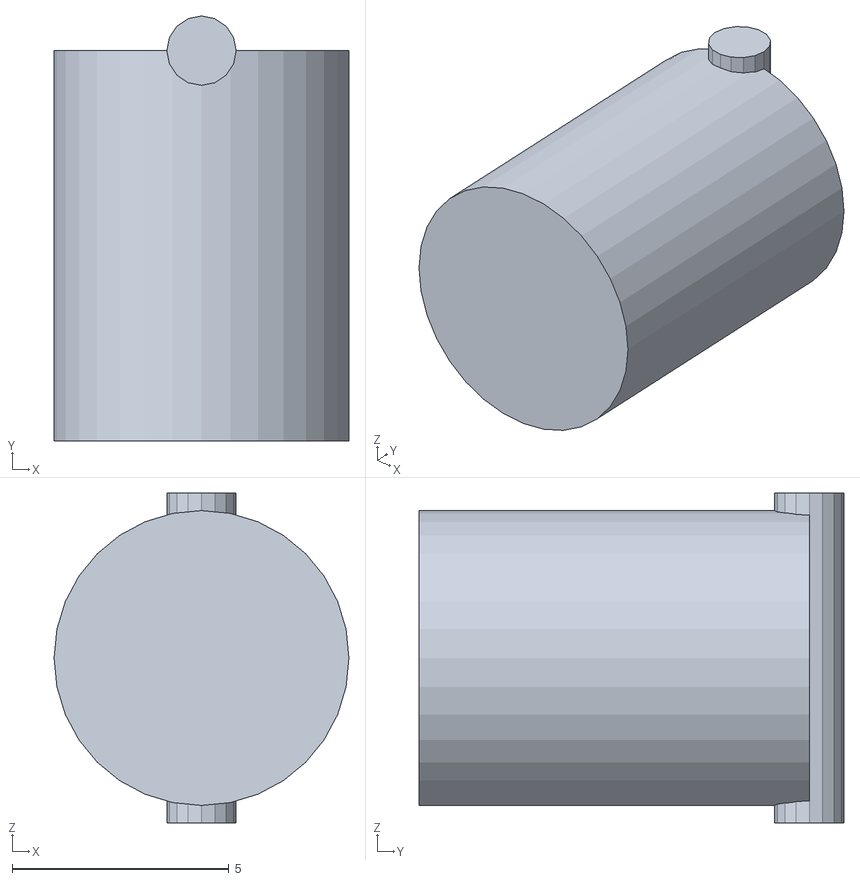
[picture p70: CAD file, 2026-10-20]
cad/stl/wrist_clevis.stl
6.80 x 9.80 x 7.60
