borthalmue/rcm7-surgical-arm/cad/stl/pitch_standoff_1.stl

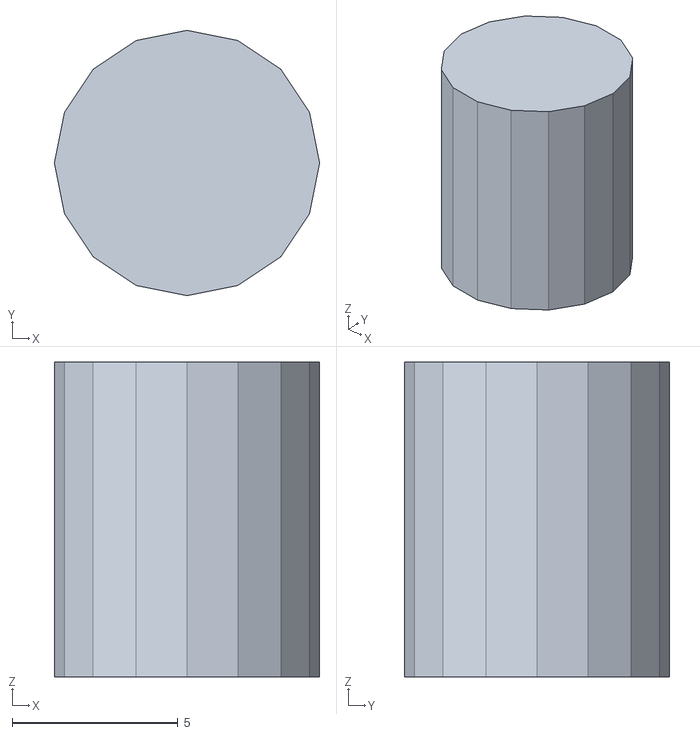
[picture p71: CAD file, 2026-10-20]
cad/stl/pitch_standoff_1.stl
8.00 x 8.00 x 9.50
