borthalmue/rcm7-surgical-arm/cad/stl/cannula.stl

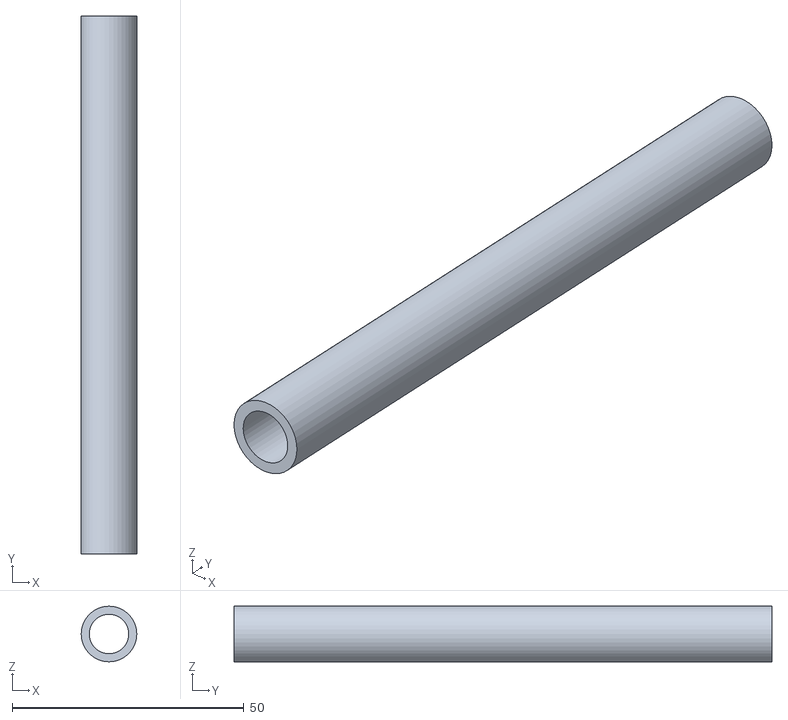
[picture p72: CAD file, 2026-10-20]
cad/stl/cannula.stl
12.0 x 116.0 x 12.0
