borthalmue/rcm7-surgical-arm/cad/stl/instrument_release.stl

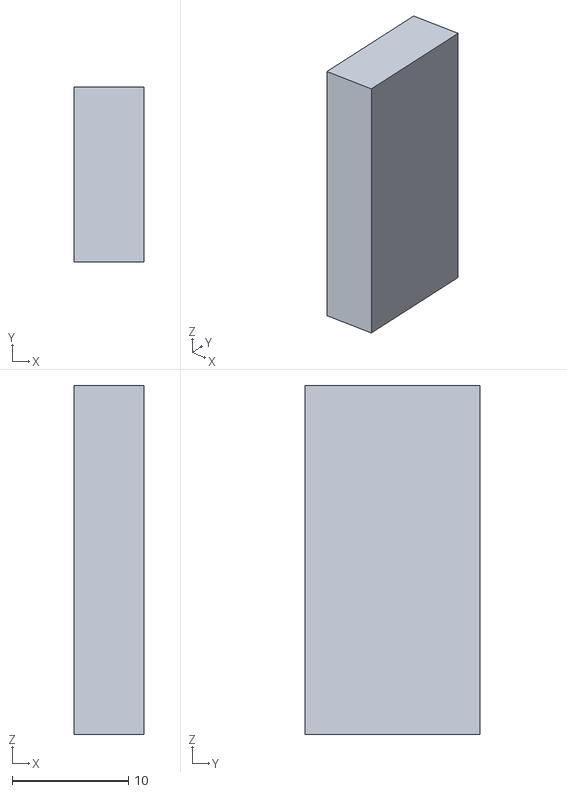
[picture p73: CAD file, 2026-10-20]
cad/stl/instrument_release.stl
6.00 x 15.0 x 30.0
