borthalmue/rcm7-surgical-arm/cad/stl/mgn12h_block.stl

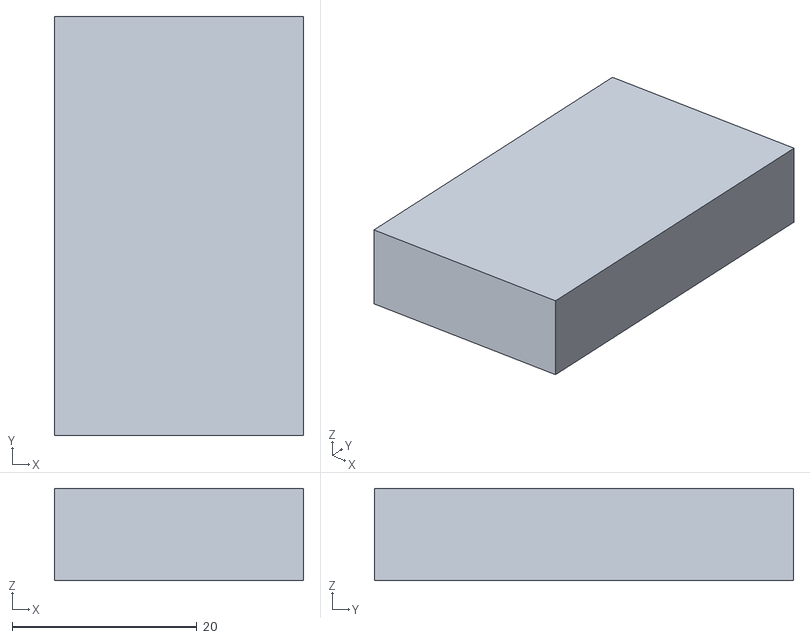
[picture p74: CAD file, 2026-10-20]
cad/stl/mgn12h_block.stl
27.0 x 45.4 x 10.0
