borthalmue/rcm7-surgical-arm/cad/stl/instrument_roll_hub.stl

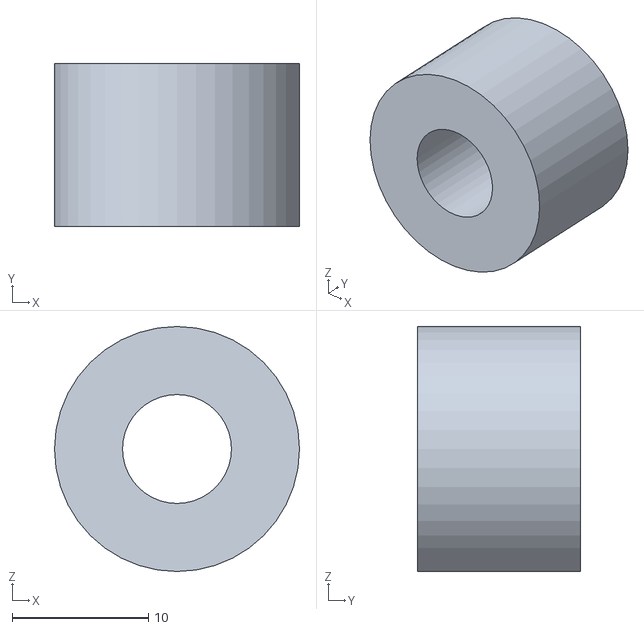
[picture p75: CAD file, 2026-10-20]
cad/stl/instrument_roll_hub.stl
18.0 x 12.0 x 18.0
