borthalmue/rcm7-surgical-arm/cad/stl/yaw_xrb_inner.stl

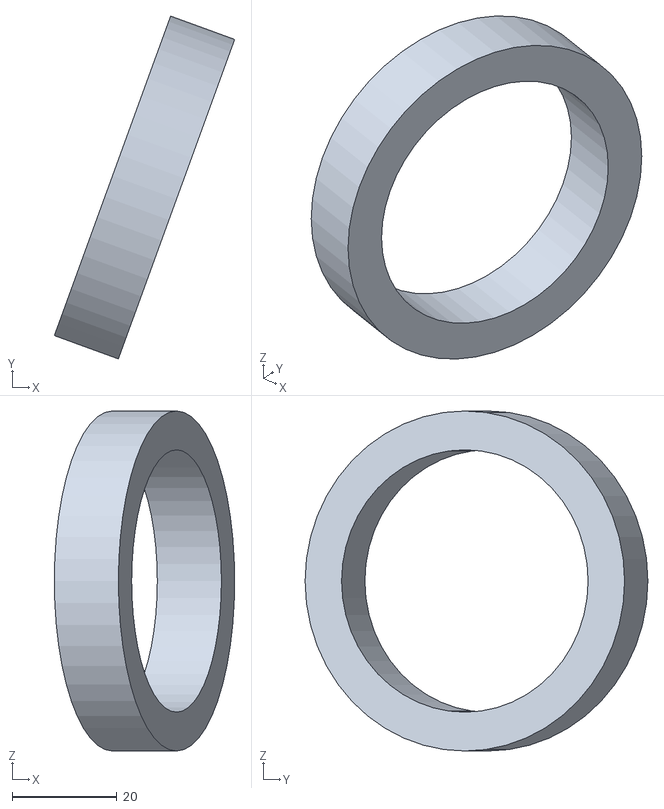
[picture p76: CAD file, 2026-10-20]
cad/stl/yaw_xrb_inner.stl
34.4 x 65.3 x 64.8
