borthalmue/rcm7-surgical-arm/cad/stl/pin_A.stl

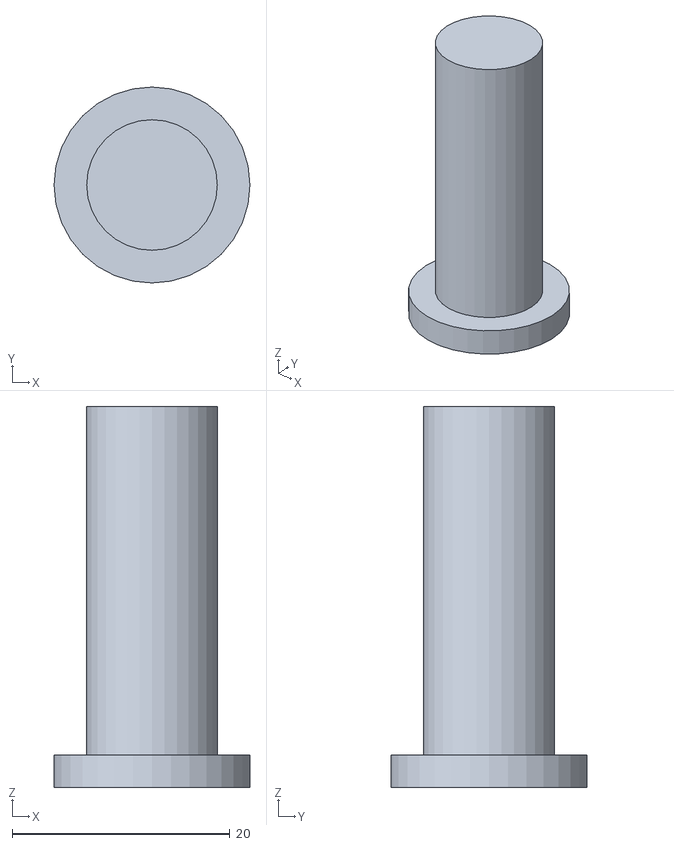
[picture p77: CAD file, 2026-10-20]
cad/stl/pin_A.stl
18.0 x 18.0 x 35.0
