borthalmue/rcm7-surgical-arm/cad/stl/yaw_xrb_outer.stl

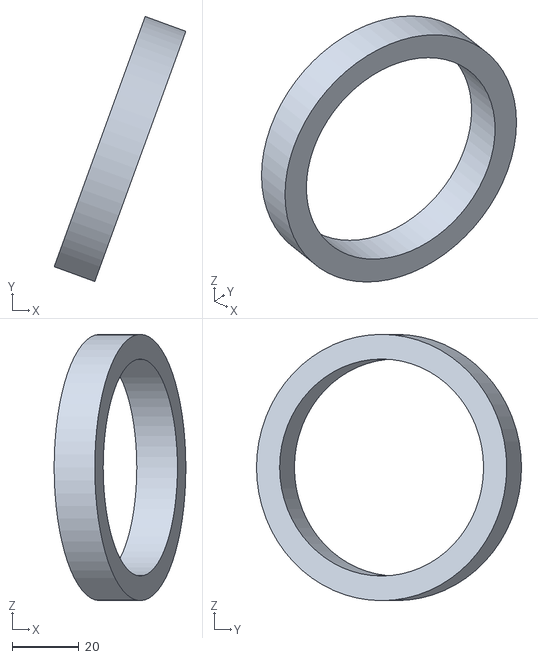
[picture p78: CAD file, 2026-10-20]
cad/stl/yaw_xrb_outer.stl
39.6 x 79.6 x 80.0
