borthalmue/rcm7-surgical-arm/cad/stl/retraction_knob.stl

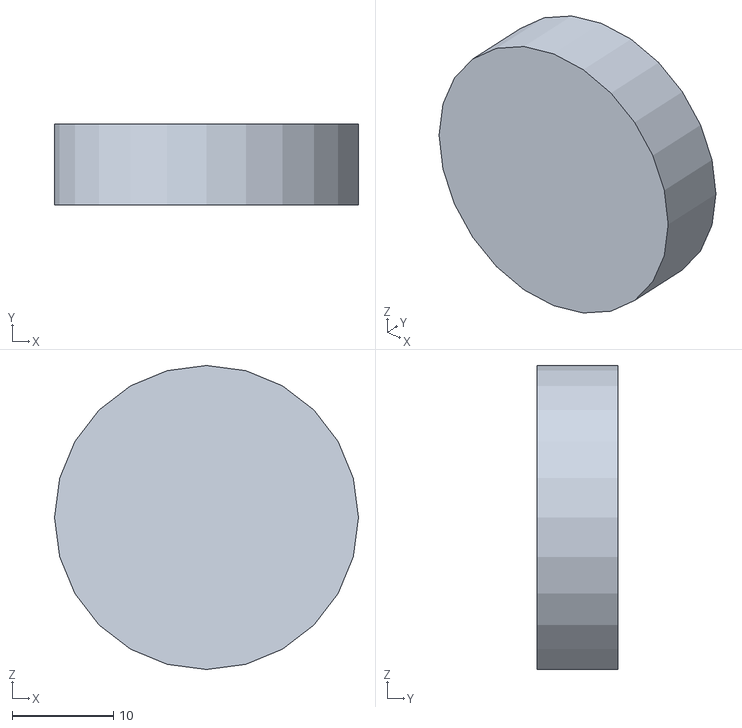
[picture p79: CAD file, 2026-10-20]
cad/stl/retraction_knob.stl
30.0 x 8.00 x 30.0
