borthalmue/rcm7-surgical-arm/cad/stl/pin_Ap.stl

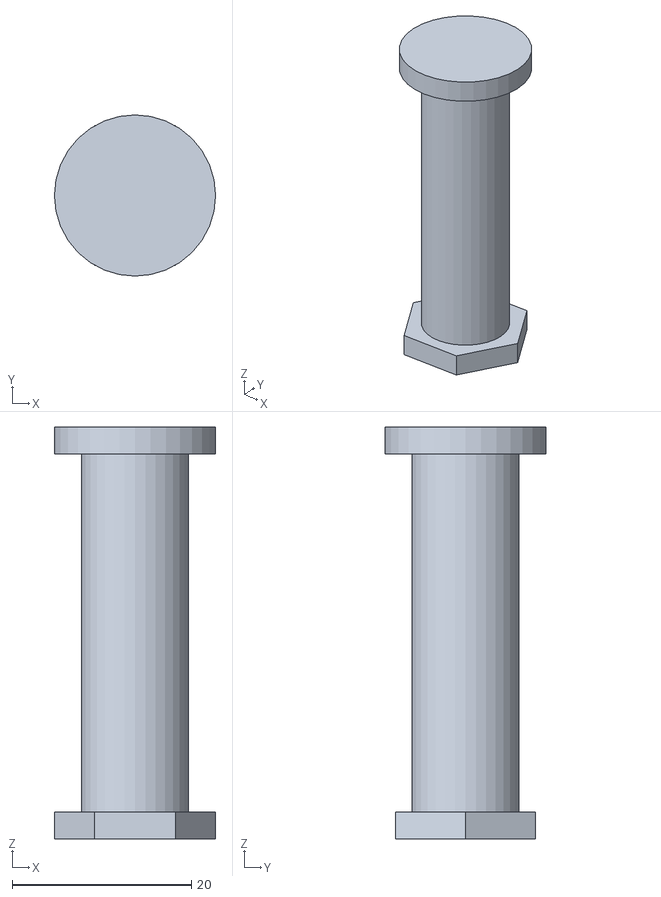
[picture p80: CAD file, 2026-10-20]
cad/stl/pin_Ap.stl
18.0 x 18.0 x 46.0
