borthalmue/rcm7-surgical-arm/cad/stl/link1_hub_tube.stl

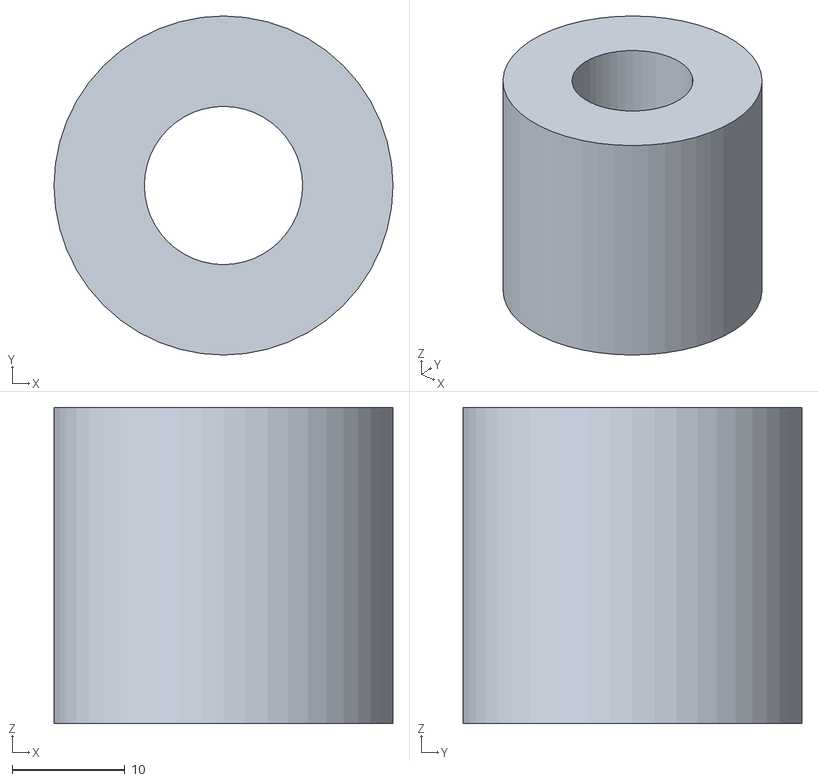
[picture p81: CAD file, 2026-10-20]
cad/stl/link1_hub_tube.stl
30.0 x 30.0 x 28.0
