borthalmue/rcm7-surgical-arm/cad/stl/yaw_output_shaft.stl

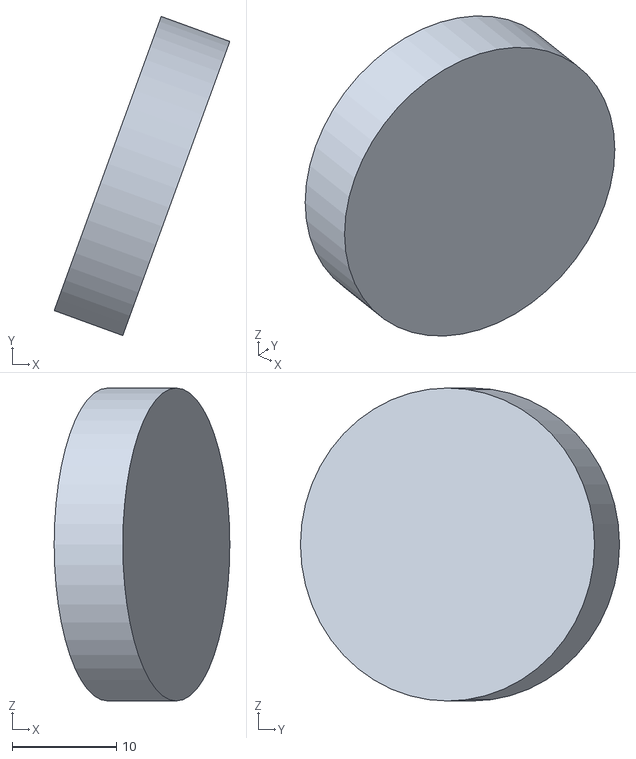
[picture p82: CAD file, 2026-10-20]
cad/stl/yaw_output_shaft.stl
16.8 x 30.6 x 30.0
