borthalmue/rcm7-surgical-arm/cad/stl/pitch_brake.stl

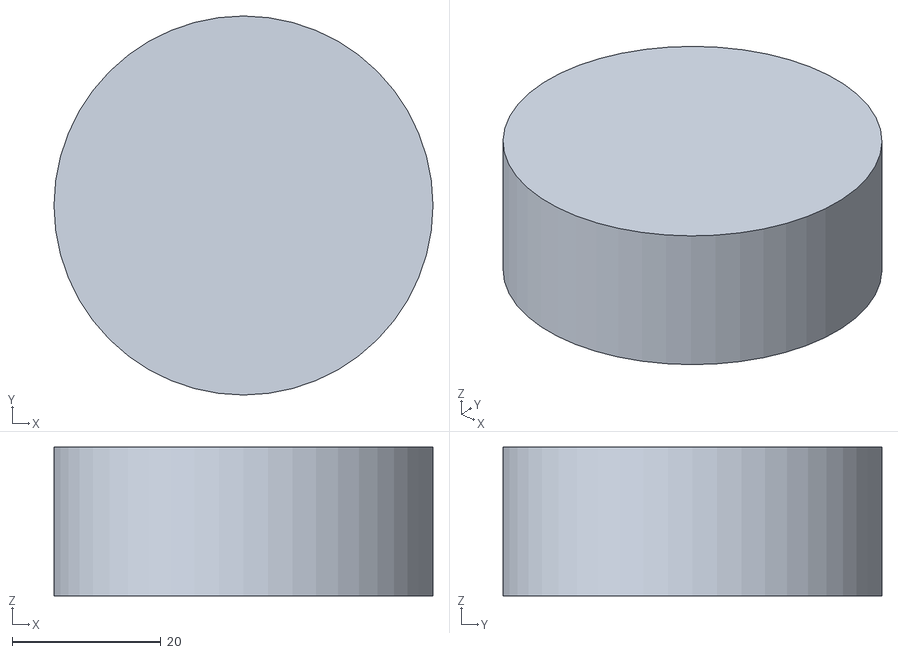
[picture p83: CAD file, 2026-10-20]
cad/stl/pitch_brake.stl
51.0 x 51.0 x 20.0
