borthalmue/rcm7-surgical-arm/cad/stl/linkOpAp_plate_back.stl

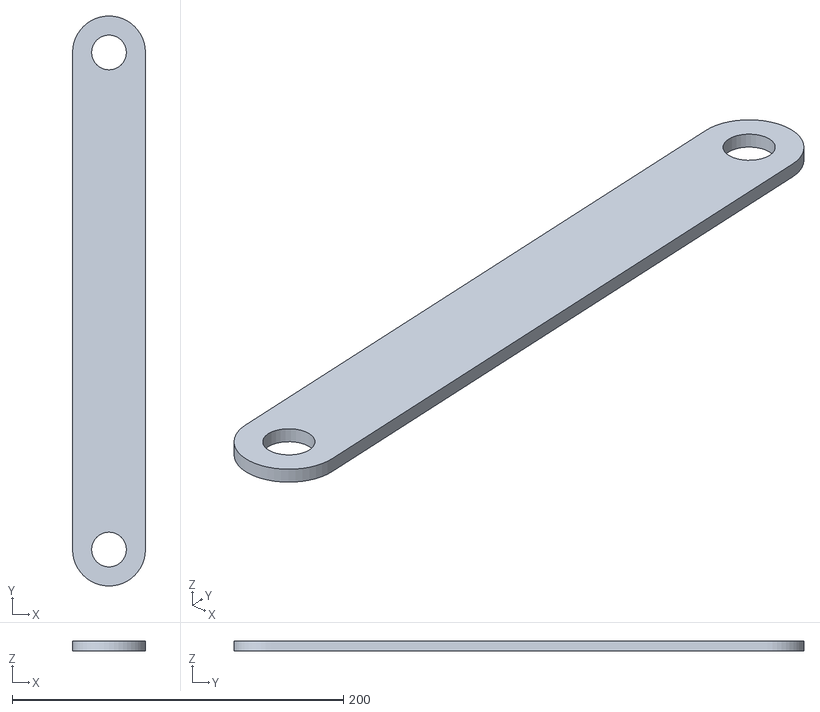
[picture p84: CAD file, 2026-10-20]
cad/stl/linkOpAp_plate_back.stl
44.0 x 344.0 x 6.00
