borthalmue/rcm7-surgical-arm/cad/stl/pitch_harmonic.stl

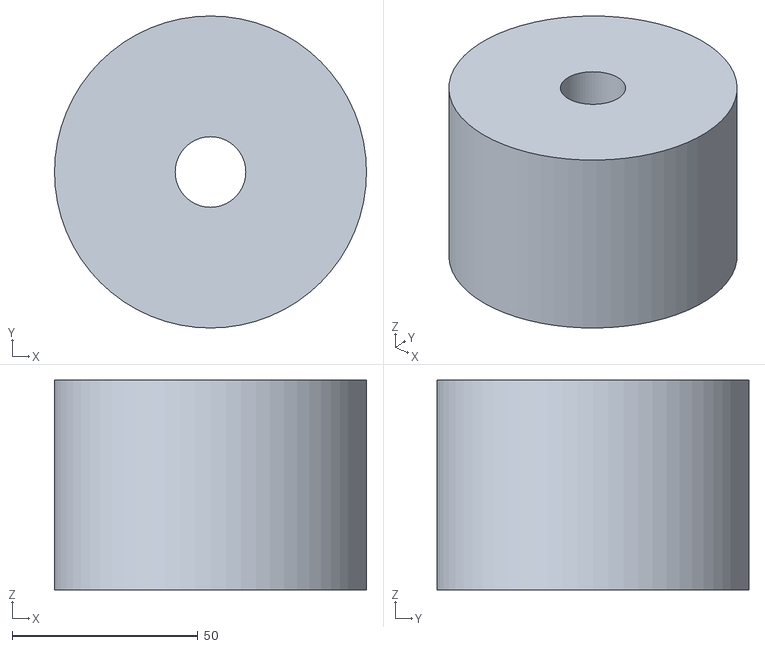
[picture p85: CAD file, 2026-10-20]
cad/stl/pitch_harmonic.stl
84.0 x 84.0 x 56.5
