borthalmue/rcm7-surgical-arm/cad/stl/yaw_brake.stl

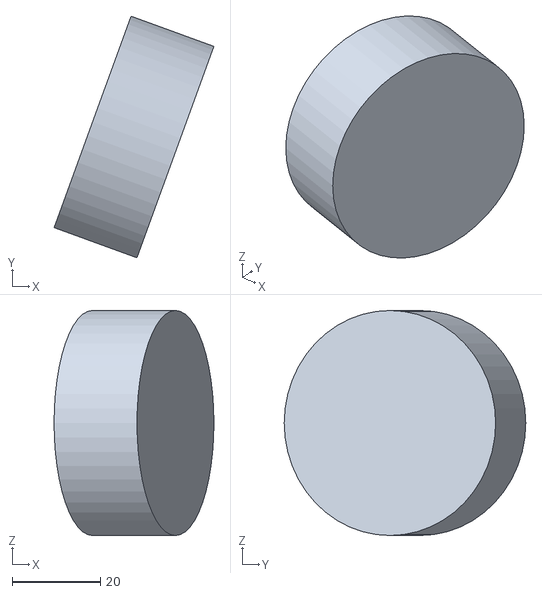
[picture p86: CAD file, 2026-10-20]
cad/stl/yaw_brake.stl
36.2 x 54.8 x 51.0
