borthalmue/rcm7-surgical-arm/cad/stl/spring_anchor_G.stl

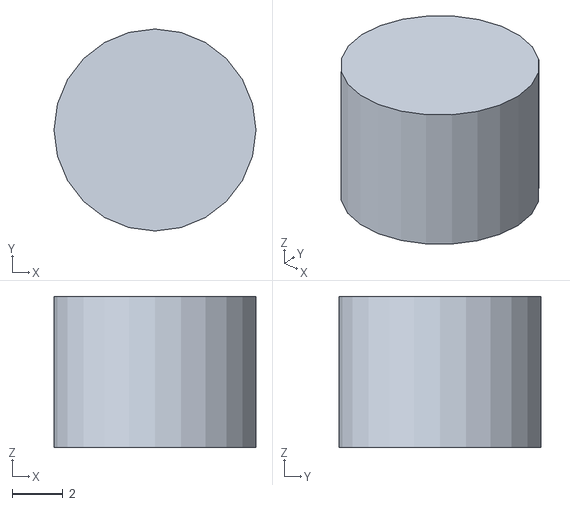
[picture p87: CAD file, 2026-10-20]
cad/stl/spring_anchor_G.stl
8.00 x 8.00 x 6.00
