borthalmue/rcm7-surgical-arm/cad/stl/yaw_enc_ring.stl

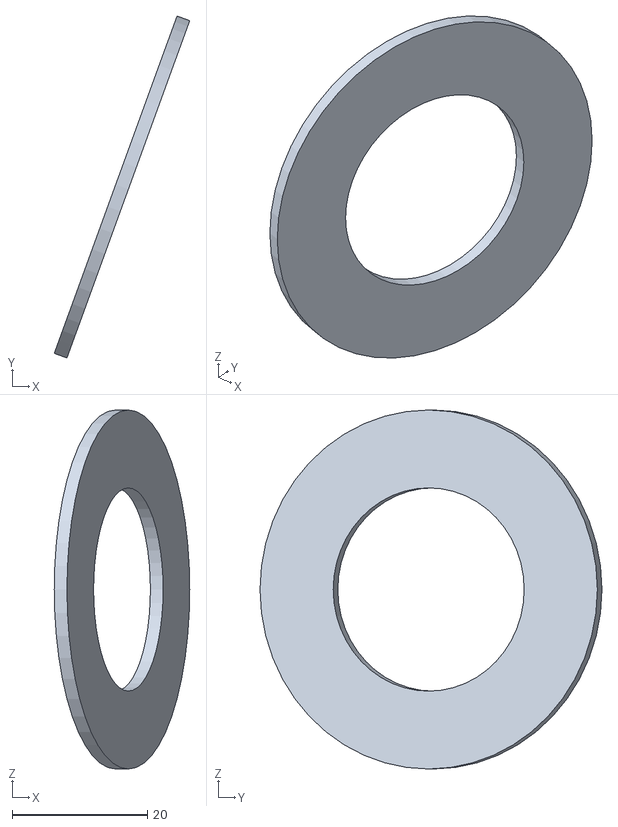
[picture p88: CAD file, 2026-10-20]
cad/stl/yaw_enc_ring.stl
20.0 x 50.5 x 53.0
