borthalmue/rcm7-surgical-arm/cad/stl/pitch_readhead.stl

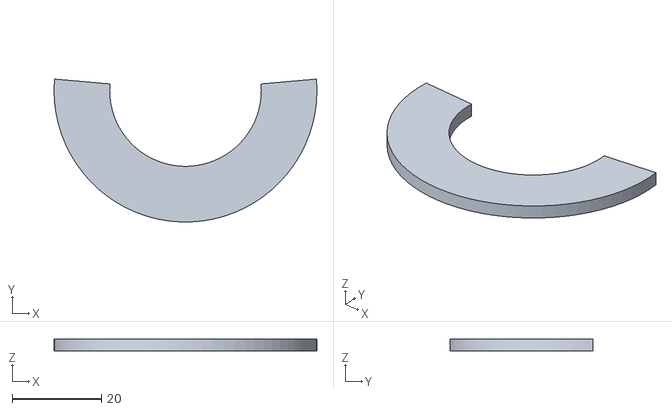
[picture p89: CAD file, 2026-10-20]
cad/stl/pitch_readhead.stl
59.0 x 32.0 x 2.80
