borthalmue/rcm7-surgical-arm/cad/stl/pitch_frame.stl

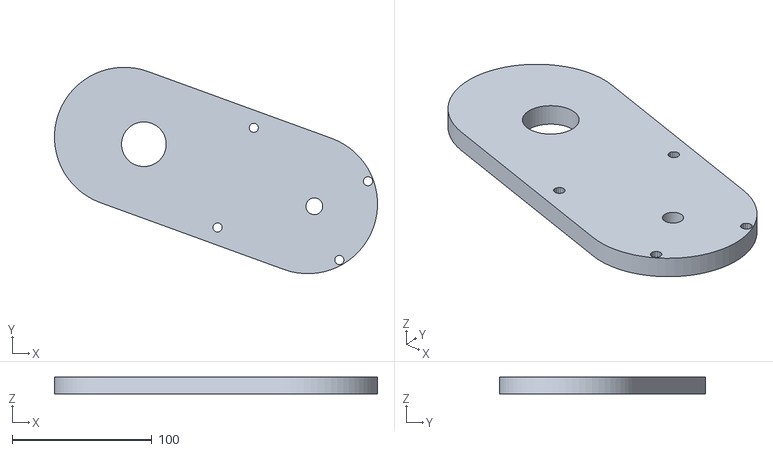
[picture p90: CAD file, 2026-10-20]
cad/stl/pitch_frame.stl
231.5 x 147.8 x 12.0
