borthalmue/rcm7-surgical-arm/(list of files, cad)

Other CAD files:
cad/stl/brg_OpAp_back_0.stl
cad/stl/brg_L1_O_front.stl
cad/stl/brg_C1_back_0.stl
cad/stl/brg_OpAp_front_300.stl
cad/stl/coupler1_rail_R.stl
cad/stl/brg_C1_back_420.stl
cad/stl/brg_C1_front_420.stl
cad/stl/brg_C2_front_0.stl
cad/stl/coupler2_rail_L.stl
cad/stl/brg_OpAp_back_300.stl
cad/stl/yaw_hardstop_1.stl
cad/stl/coupler1_wall_front.stl
cad/stl/brg_C1_front_0.stl
cad/stl/brg_C2_front_420.stl
cad/stl/yoke_gusset_L.stl
cad/stl/link1_spacer_358.stl
cad/stl/coupler2_wall_front.stl
cad/stl/insertion_stop_-40.stl
cad/stl/coupler1_wall_back.stl
cad/stl/isa_motor_4.stl
cad/stl/imu_spar.stl
cad/stl/brg_C2_back_0.stl
cad/stl/spar_plate_back.stl
cad/stl/pitch_hardstop_1.stl
cad/stl/spar_spacer_-130.stl
cad/stl/insertion_motor_enc.stl
cad/stl/coupler1_rail_L.stl
cad/stl/brg_C2_back_420.stl
cad/stl/pulley_2a_A.stl
cad/stl/pitch_standoff_2.stl
cad/stl/spar_spacer_176.stl
cad/stl/pin_E.stl
cad/stl/linkOpAp_spacer.stl
cad/stl/linkOpAp_plate_front.stl
cad/stl/isa_motor_1.stl
cad/stl/jaw_2.stl
cad/stl/isa_motor_3.stl
cad/stl/pin_F.stl
cad/stl/pitch_motor.stl
cad/stl/ball_nut.stl
cad/stl/ballscrew_SFU1204.stl
cad/stl/nut_bracket.stl
cad/stl/screw_BF10.stl
cad/stl/screw_BK10.stl
cad/stl/screw_bracket_-202.stl
cad/stl/screw_bracket_196.stl
cad/stl/screw_coupling.stl
